Miguel-SLO/2228_AlarmeFenetre/2228_AlarmeFenetreOuverte/doc/Captures/2228_AlarmeSurFenetre.png

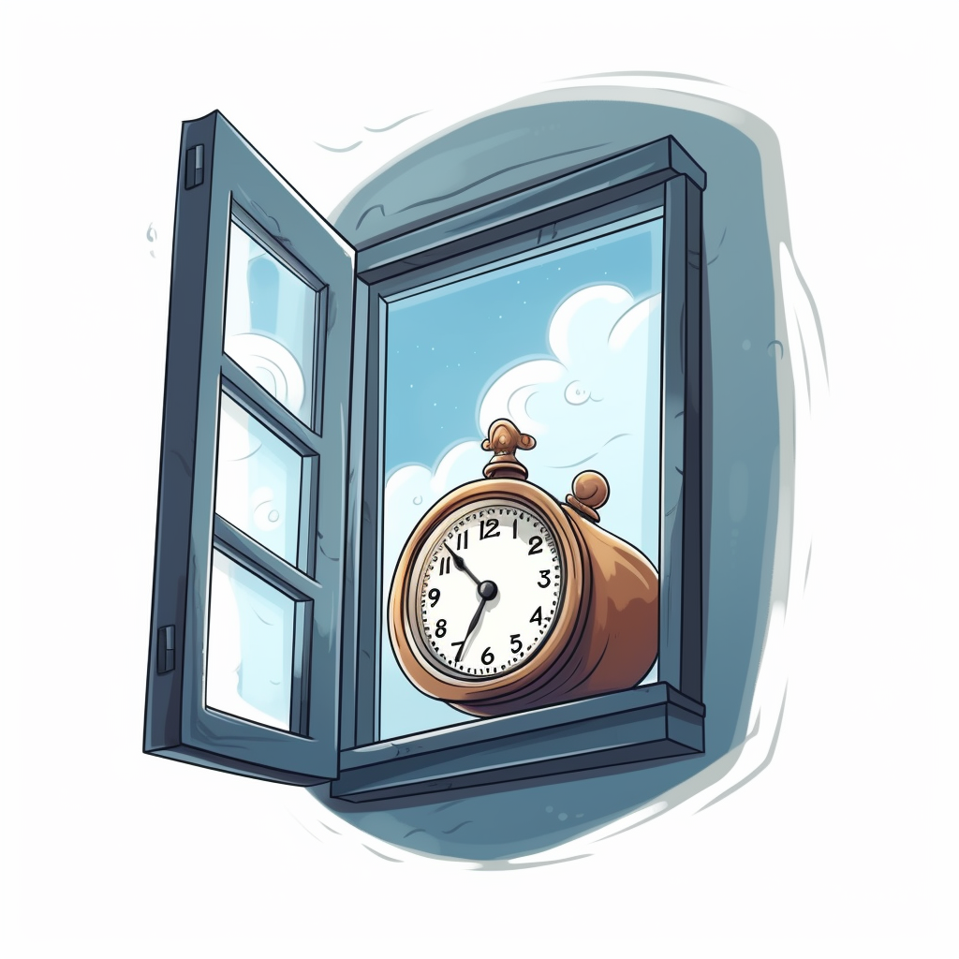
2228_AlarmeFenetreOuverte/doc/Captures/2228_AlarmeSurFenetre.png
