Miguel-SLO/2228_AlarmeFenetre/2228_AlarmeFenetreOuverte/doc/2228_AlarmeFenetreOuverte-Rapport-V1.docx

Génie électrique / électronique 3e semestre 2022-2023

Rapport de projet

2228

Alarme de fenêtre ouverte

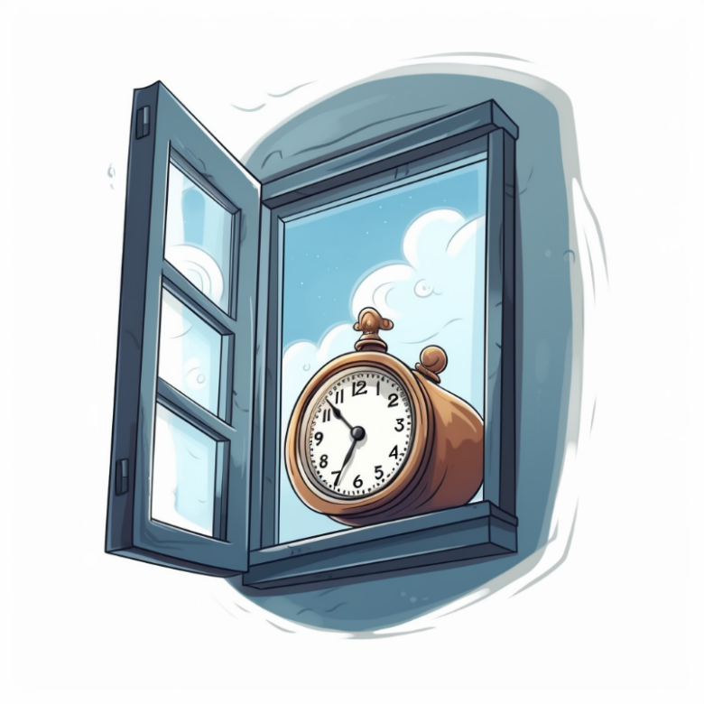
[picture p2: figure]

Réalisé par : À l’attention de :

Miguel Santos Serge Castoldi

Juan José Moreno

Début Fin

16 novembre 2022 14 juin 2023

# 1. Introduction

L’objectif de ce projet est la réalisation d’un dispositif permettant de détecter si une fenêtre est restée ouverte à certaines heures dans une salle de l’ETML-ES. Le cas échéant, une alerte sera envoyée par e-mail. Ce projet s’inspire des produits déjà présents sur le marché de la domotique.

Le cahier des charges est fournis à l’annexe 11.3.

Le planning complet du projet est fournis à l’annexe 11.5.

# 2. Pré-étude

## 2.1. Approche

Le projet sera constitué de deux parties distinctes :

- Multiples émetteurs, disposés à chaque fenêtre souhaitée.
- Un unique récepteur, placé dans la même salle que les fenêtres.

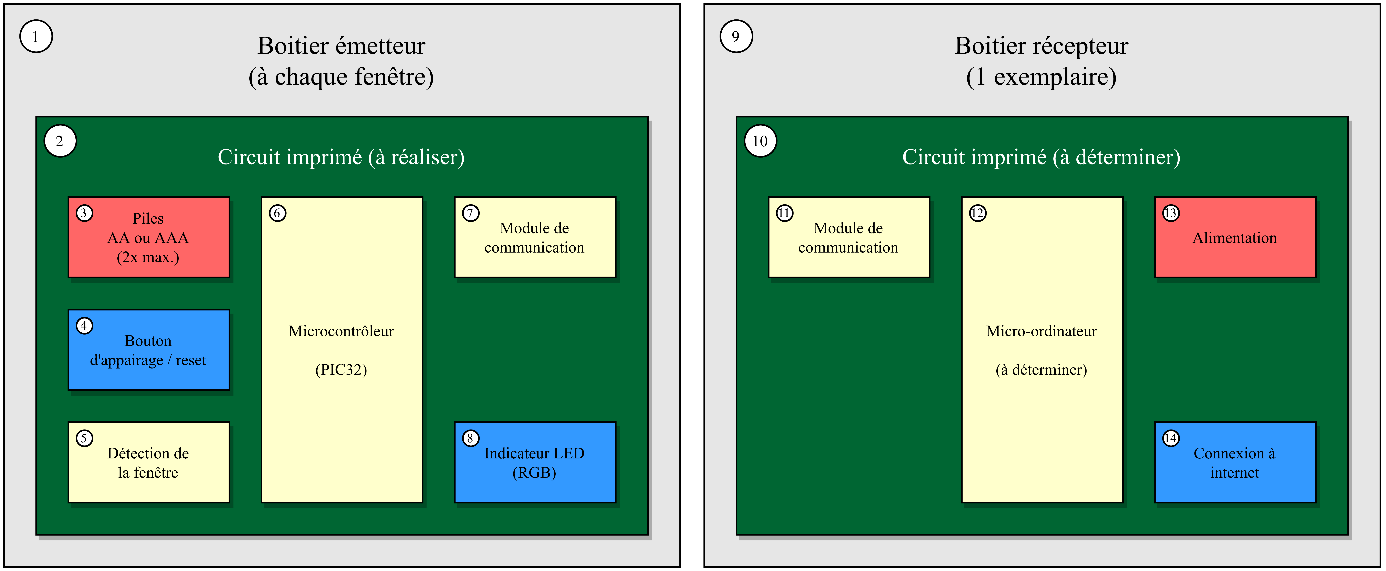
[picture p3: figure]

Figure 1 : Schéma-bloc de l'approche

## 2.2. Détection de la fenêtre

Pour réaliser la détection de la fenêtre, je me suis basé sur les produits équivalents disponible sur le marché. La méthode consiste à placer un aimant permanent sur la fenêtre et à le détecter à l’aide d’un capteur à effet Hall.

L’avantage réside dans la fiabilité de la mesure. La probabilité d’avoir un autre aimant perturbant notre circuit est extrêmement faible. En comparaison, un capteur optique pourrait se voir perturbé par de l’eau, une feuille ou tout autre objet se plaçant devant le capteur.

La consommation de ce genre de circuit est faible et sont proposé à de faibles prix. Ce qui en fait un choix idéal pour cette application.

## 2.3. Bouton

Un bouton sera accessible depuis l’extérieur du boitier pour permettre à l’utilisateur la réalisation de l’appairage ou de diverses configurations si nécessaires

## 2.4. LED RGB

Une LED sera placé afin d’indiquer à l’utilisateur l’état de chaque émetteur lors de l’appairage ou si une erreur survient par exemple. Elle devra être éteinte lors d’un fonctionnement normal pour réduire la consommation de courant.

## 2.5. Alimentation

Le cahier des charges proposait l’utilisation de deux piles AAA. Néanmoins, je me suis rapidement rendu compte des avantages que peuvent offrir des batteries au lithium. Pour cette raison, j’ai décidé de proposé deux approches différentes pour réaliser l’alimentation du circuit.

| Avantages | Inconvénients
Piles AAA alcaline | Facilité d’entretien Facilité de développement | Coût sur le long terme Grande quantité de déchets
Batterie lithium | Meilleure densité d’énergie Meilleure durabilité | Développement plus complexe Nécessite des circuits de charge et de protection Recharge annuelle nécessaire

Figure 2 : Comparaison entre piles et batterie

Le design devra déterminer lequel de ces deux méthodes sera le plus adapté à implémenter dans ce projet.

Dans les deux cas, un circuit de mesure de la charge du niveau d’énergie restant devra être réalisé. Il devra faire preuve d’un courant de fuite le plus faible possible.

## 2.6. Microcontrôleur et module de communication

### 2.6.1 Méthode PIC32

Pour cette partie, j’ai étudié deux méthodes différentes. La première était basé sur l’utilisation d’un PIC32 couplé à un module Xbee, intégrant un processeur ARM, permettant une communication par le protocole Zigbee.

Après avoir commencé ma pré-étude sur cette partie, j’ai jugé qu’il était peut-être exagéré d’intégrer deux processeurs pour une application qui est peu gourmande en ressources. De plus, le prix unitaire se retrouvait être très élevé.

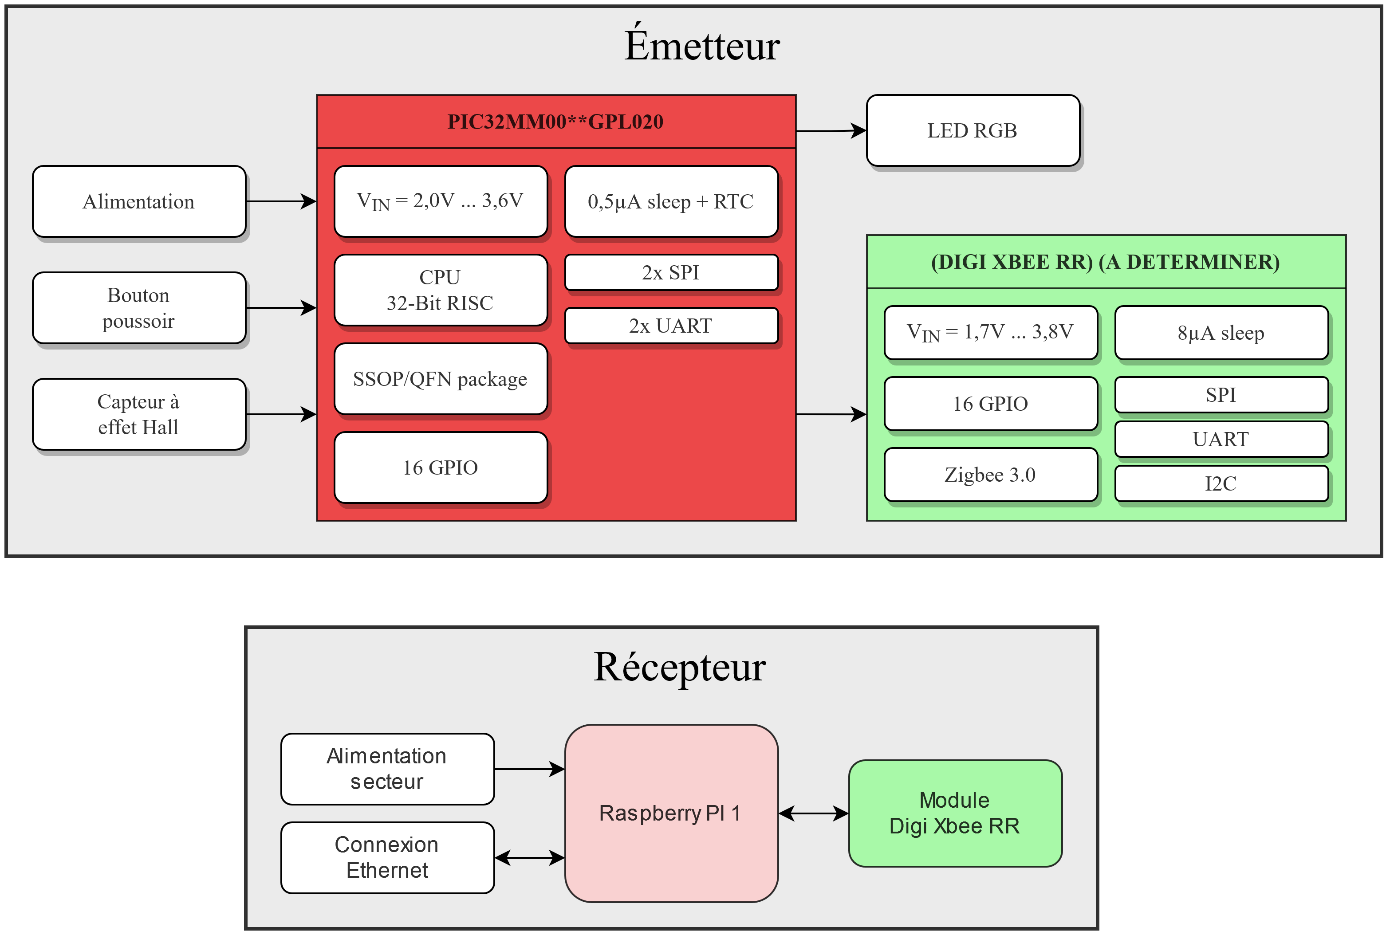
[picture p4: figure]

### 2.6.2 Méthode Nordic

J’ai donc étudié la possibilité d’utiliser un module « NRF52820 » du fabricant « Nordic Semiconductor ». J’ai eu l’occasion de le survoler rapidement lors de mon stage en entreprise. Il a l’avantage d’intégrer à la fois un CPU et un module de communication Zigbee, ainsi que plusieurs autres périphériques. De plus, il offre un prix bien plus avantageux que la méthode avec le PIC32.

Néanmoins, il était demandé d’intégrer un PIC32 dans le projet. Pour cela, j’ai donc décidé de le réaliser dans

Je souhaiterais privilégier cette méthode pour ces avantages techniques et économiques. Néanmoins, elle présente le désavantage d’être plus complexe à implémenter, mais cela me permettrait d’améliorer mes compétences personnelles en prévision de l’entreprise que j’intégrerai à la suite de mes études.

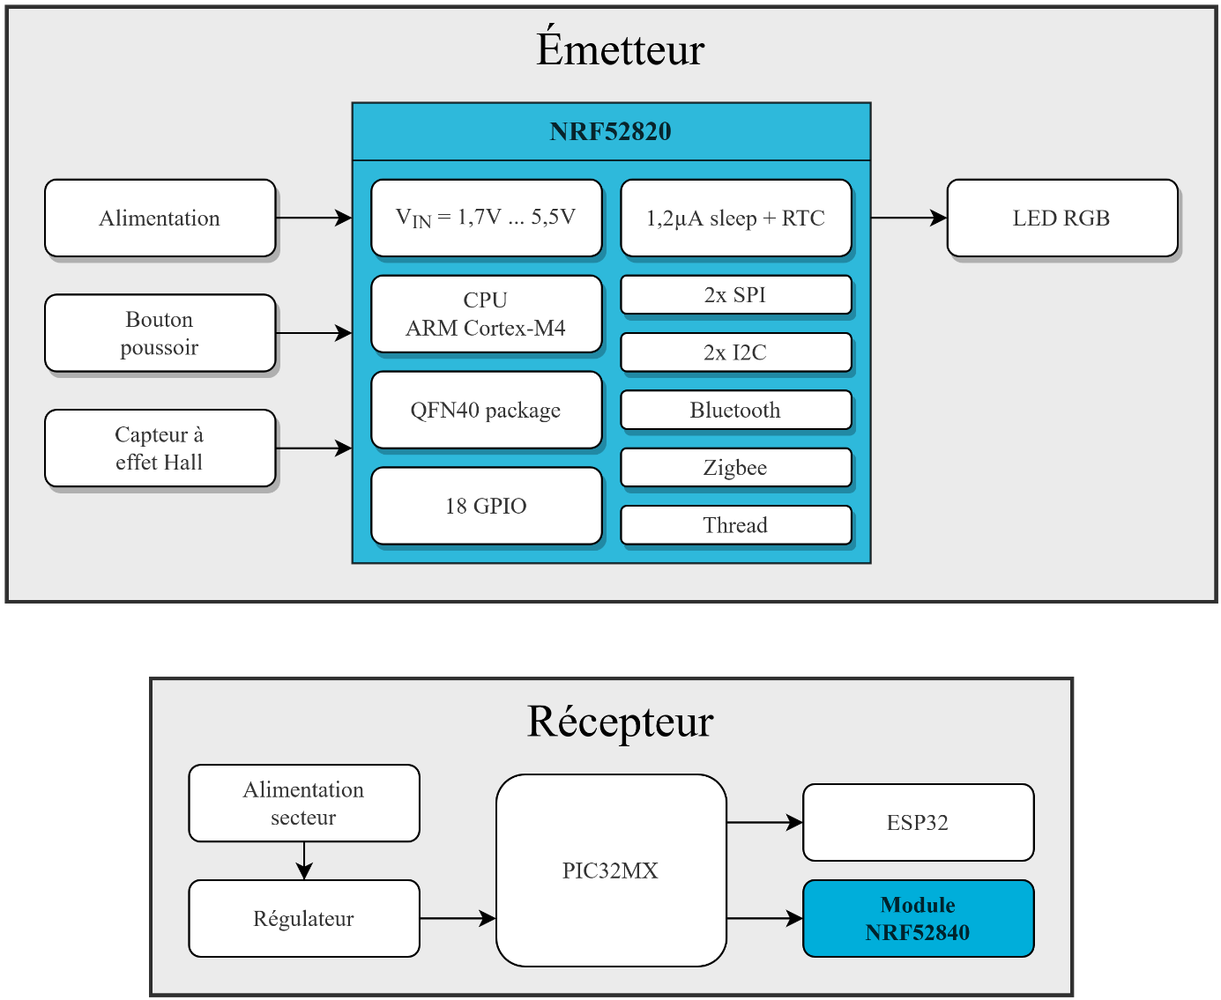
[picture p5: figure]

# 3. Boitiers

La réalisation des boitiers sera faite en impression 3D. De cette manière, une plus grande flexibilité est des designs plus pratique seront possible pour un coût équivalent en contrepartie de temps supplémentaires pour la conception.

# 4. Évaluation des coûts

Comme j’ai proposé deux méthodes pour ce projet, j’ai réalisé deux estimations des coûts distinctes. Certaines parties sont communes aux deux méthodes.

J’ai réalisé une estimation par unité, pour une salle complète (en moyenne 15 fenêtres) et une estimation si le projet devait être étendu à l’entièreté de l’école (environ 150 fenêtres) en considérant que chaque salle serait équipé d’un récepteur.

On peut voir que la méthode Nordic offre un avantage financier non négligeable. Ce qui appui ma volonté d’utiliser cette méthode.

# 5. Design

## 5.1. Choix des composants : Émetteur

### 5.1.1 Schéma bloc de l’émetteur

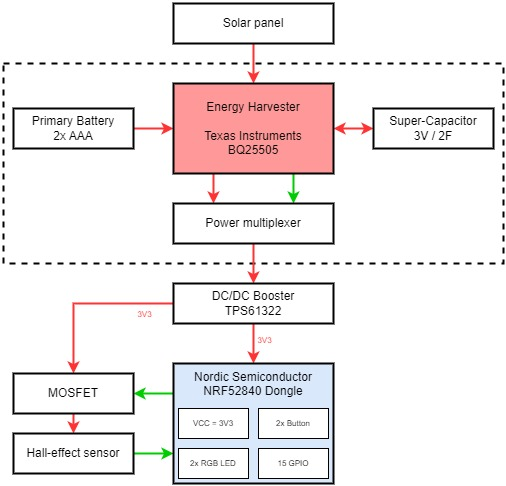
[picture p6: figure]

### 5.1.2 Cellule photovoltaïque | KXOB25-05X3F-TR

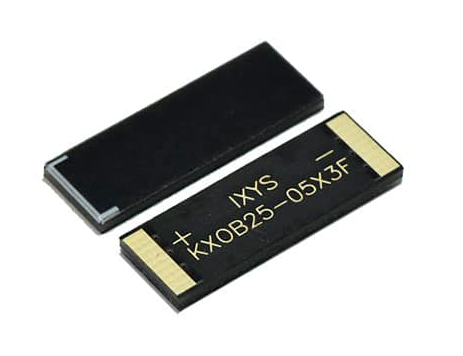
[picture p7: figure]

Le panneau solaire représente la source d’énergie principale de l’émetteur. Il devrait lui permettre d’atteindre une autonomie complète sans nécessiter de changement de piles ou batteries.

Composé de cellule photovoltaïque monocristalline, cela permettra d’exploiter toute la longueur d’onde de la lumière visible et en conséquence la lumière intérieure des néons.

Figure 3 : Cellule solaire ANYSOLAR

Le rendement élevé (25%) permettra de maximiser la quantité d’énergie captée dans une surface réduite. Les tensions sont parfaitement adaptées à la plage de fonctionnement du circuit de gestion décrit aux points suivants.

### 5.1.3 Energy harvester | BQ25505

Le BQ25505 de Texas Instrument est un circuit permettant la gestion de source d’énergie de très faible puissance. Il est en mesure de gérer le stockage dans un super-condensateur. En plus de cela, une batterie primaire peut-être relié au circuit pour offrir une source d’énergie supplémentaire et plus stable.

La datasheet fournit une application typique avec une cellule solaire.

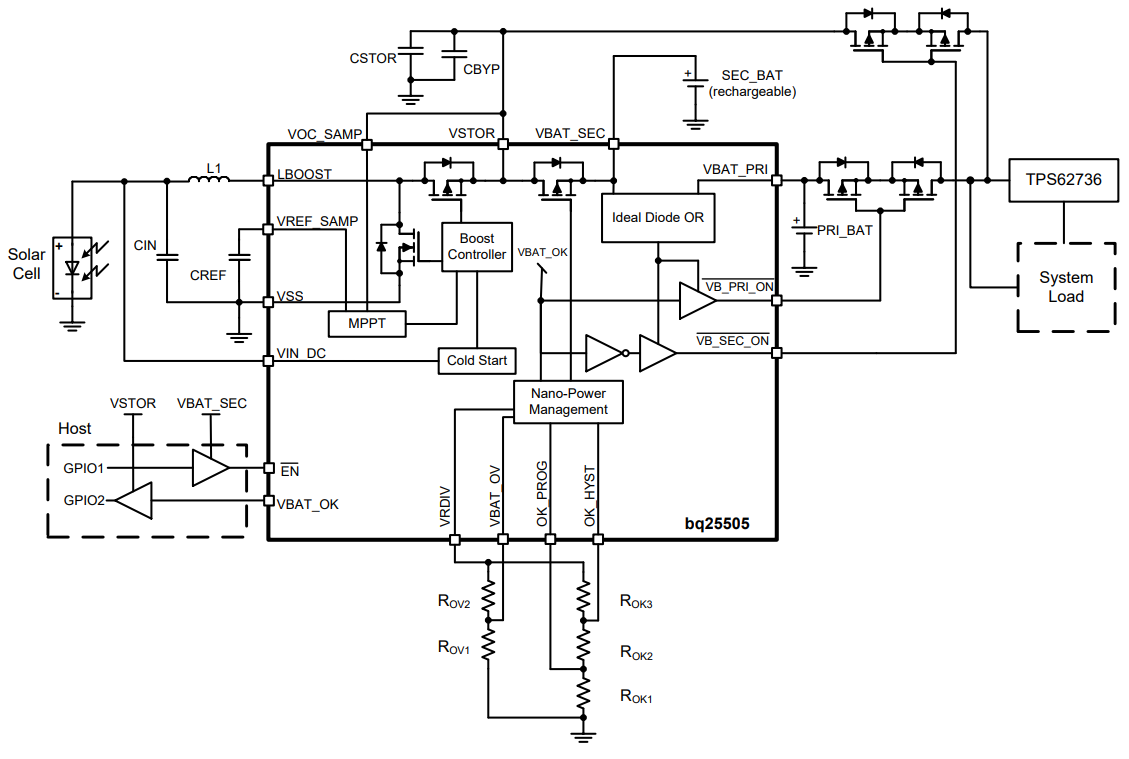
[picture p8: figure]

Figure 4 : Application typique BQ25505

#### Chargeur boost | C2 & L1

En entrée, un boost permet d’élever la tension de la cellule solaire. Les valeurs de composants à utiliser sont fournis par la datasheet (p. 20).

#### Protection de surtension | R1 & R2

Un pont résistif permet de fixer la tension maximale admissible sur la batterie secondaire (le super-condensateur). La formule est fournie par la datasheet (p. 13).

V_(BAT_(OV)) =3/2*V_(BIAS) *(1+(R_(OV2))/(R_(OV1)))

V_(BIAS) =V_(RDIV) =1.21 V

R_(OV2) +R_(OV1) =13 MΩ

Dû aux valeurs élevés de résistance et donc de courant très faible, une attention particulière doit être faite concernant le bruit pouvant perturber ce pont. De plus, les produits appliqués sur le circuit tel que le flux de la soudure ou les produits de nettoyages peuvent engendrer une résistance parallèle du même ordre de grandeur. Le fabricant fournit des recommandations dans la datasheet à ce sujet.

Figure 5 : Pont résistif fixant la valeur de protection de surtension

#### Stockage d’énergie | B1 & B2

Pour stocker l’énergie, un super-condensateur est utilisé. Celui-ci a été dimensionné grâce à un outil de calcul fourni par Texas Instrument. La plage de tension utile est celle entre la tension minimale de sortie du BQ25505 et la tension maximale du condensateur. Pour maximiser cette plage, il faut donc choisir un condensateur avec la plus haute tension possible. Néanmoins, pour éviter d’avoir des coûts trop élevés, j’ai préféré en choisir un d’une tension de 3V avec une plus grande capacité.

Figure 6 : Stockage d'énergie

#### Condensateurs | C3 & C4 & C5

Le condensateur C3 est nécessaire pour que le circuit puisse fixer sa tension de référence en interne. Il est particulièrement sensible aux courant de fuites et doit les éviter au maximum tout en étant d’une précision la plus grande possible. Il doit être au minimum de type X7R ou COG.

Les condensateurs C4 et C5 sont les condensateurs de sortie et leur valeur est fixée par la datasheet.

De manière globale, tous les condensateurs reliés au BQ25505 doivent posséder le courant de fuite le plus faible possible afin augmenter le rendement global.

Figure 7 : Condensateurs de sortie | Figure 8 : Condensateur de référence

#### Multiplexeur | U5 & U6

Le BQ25505 offre la possibilité de multiplexer les différentes sources de stockage pour notamment automatiquement commuter sur la batterie primaire lorsque la secondaire n’a plus assez d’énergie ou une tension trop faible.

### 5.1.4 Régulateur 3V3 | U4

La tension fournit par le super-condensateur sera variable par nature. Pour la stabiliser, il faut veiller à utiliser un régulateur 3V3. Les composants ont été dimensionné grâce à l’utilitaire « WEBENCH » de Texas instrument.

### 5.1.5 Capteur à effet hall

Pour détecter la présence ou non de la fenêtre, j’ai décidé d’implémenter un capteur à effet hall agissant comme un interrupteur. La présence d’un champ magnétique supérieure à une valeur définie fera passer la sortie à un niveau logique haut.

Pour réduire le risque de courant de fuite dans le capteur, un MOSFET est installé sur son alimentation qui sera contrôlé par le processeur.

### 5.1.6 NRF52840 USB Dongle

Le processeur utilisé sera le NRF52840 de Nordic Semiconductor. Pour simplifier le développement, j’ai choisi un module tout-en-un.

Le module permettra la communication en Zigbee avec le récepteur. Pour le programmer, une connexion par USB à un ordinateur sera suffisante. Nordic fournit plusieurs logiciels et exemple de code pour cela.

## 5.2. Choix des composants : Récepteur

### 5.2.1 Schéma bloc du récepteur

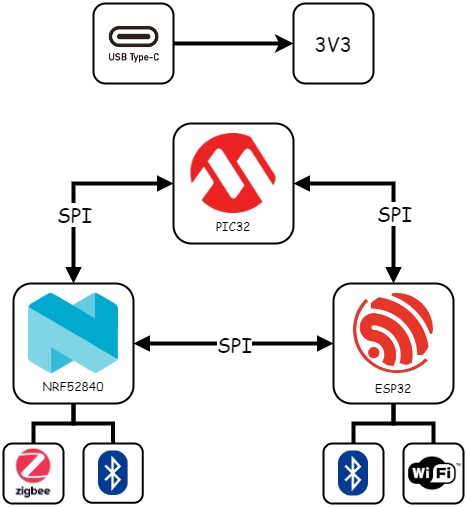
[picture p9: figure]
schemaBloc_Recepteur

### 5.2.2 Connecteur USB

Le récepteur sera alimenté à l’aide de la tension de 5V fournit par un port USB-C.

### 5.2.3 Régulateur 3V3

Pour assurer l’alimentation des différents circuits, une conversion en 3V3 est nécessaire. Mon choix a été mis en commun avec le restant de la classe et en fonction du stock disponible à l’ES.

### 5.2.4 Processeurs et empreintes MIKROE

Le même module NRF52840 utilisé pour l’émetteur sera présent pour assurer la communication en Zigbee.

Des empreintes MIKROE ont été utilisé afin de permettre une certaine flexibilité dans le choix d’un module pour réaliser la connexion WIFI

Un PIC32 assurera le contrôle central entre les différents modules à l’aide de connexions SPI et UART.

# 6. Hardware

## 6.1. PCB de l’émetteur

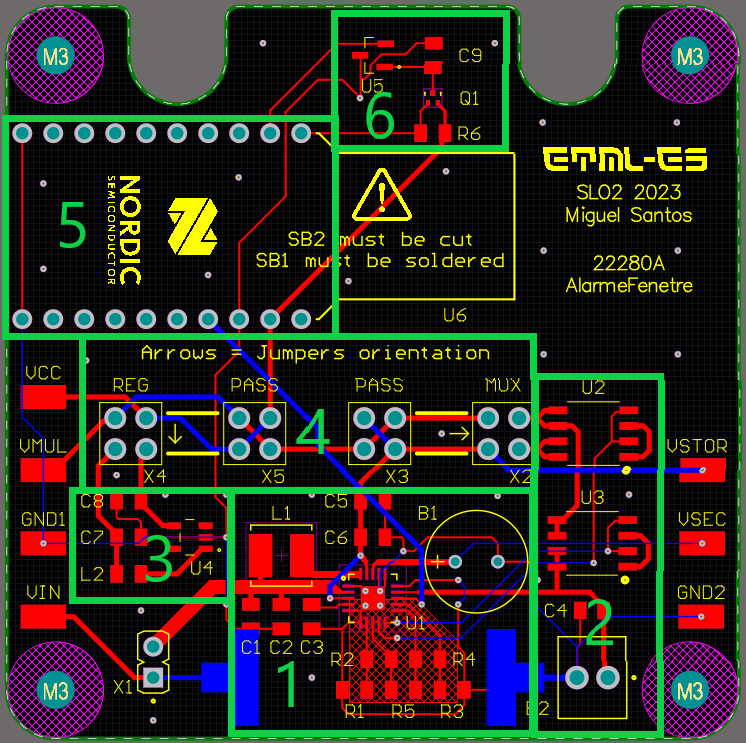
[picture p10: figure]

Figure 9 : PCB de l'émetteur

Les plans de masse ont été retirés de l'image pour améliorer la visibilité des pistes et des composants.

Les encoches sur le bord du PCB sont destinées à permettre le passage des colonnettes du boîtier, ce qui permet de gagner de la place. Les trous dans les coins servent à fixer le PCB solidement à l'intérieur du boîtier.

Les pointes de test ont été placées sur les bords du circuit pour faciliter l'accès avec des sondes de mesure lors des tests.

Les éléments identifiés sur l'image (Figure 9) sont décrits ci-dessous :

1) Panneau solaire | « Energy harvester » | Super-capacité

La piste VIN a été conçue aussi large que possible pour minimiser l'impédance. Étant donné les très faibles courants en jeu, la largeur de la piste a peu d'importance

Le panneau solaire est placé sur la couche inférieure pour qu’il puisse être le plus près possible de l’extérieur du boitier. La forme en "T" du footprint a été spécifiquement choisie pour faciliter le processus de brassage des pads qui ont leurs connexions uniquement en dessous du composant.

Une zone de "keep-out" est placée autour des ponts résistifs, qui ont des valeurs élevées, pour éviter les impédances parasites.

Les condensateurs C1 à C3 sont placés au plus proche de l’entrée du BQ25505.

Les composants sont légèrement espacés de la bobine L1 pour éviter les perturbations causées par le boost en entrée.

2) Multiplexage des sources d’alimentations

Placé pour garantir le chemin le plus court entre la pile et les jumpers

3) Régulateur 3V3
4) Bypass des blocs

L’orientation de placement des jumpers est indiquée par des flèches.

Les jumpers « PASS » peuvent être placés dans n’importe quel sens

Les circuits sont protégés physiquement si jumpers placés dans le mauvais sens.

5) NRF52840 USB Dongle

Le fabricant recommande de ne rien placer sous la partie de l’antenne présente sur le module, c’est pour cette raison qu’il dépasser légèrement du bord du PCB.

6) Capteur magnétique

Placé au bord du circuit pour détecter l’aimant externe.

Les différents fichiers nécessaires à la production sont fournis en annexe.

## 6.2. PCB du récepteur

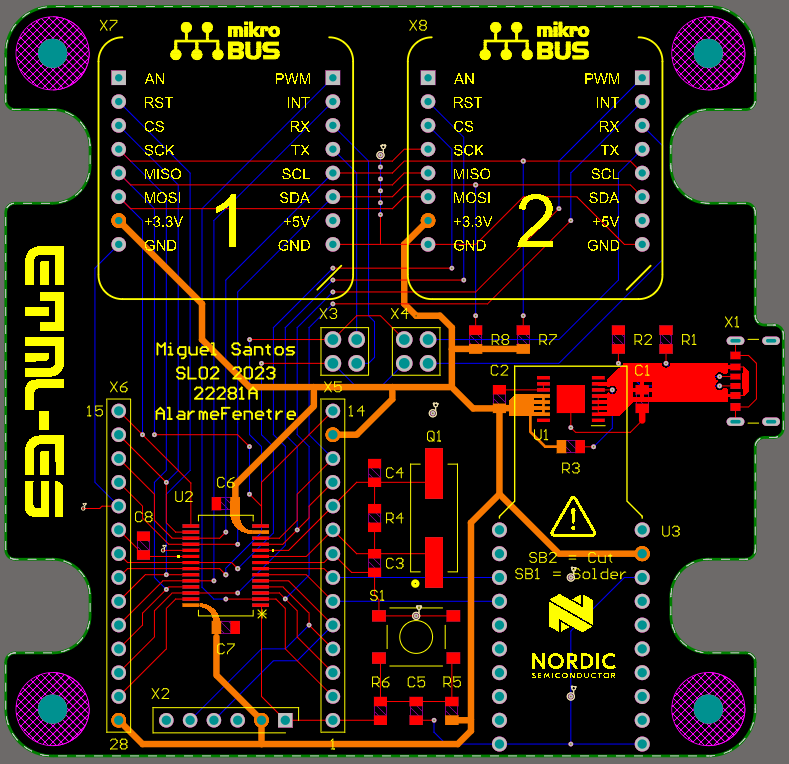
[picture p11: figure]

Figure 10 : PCB du récepteur

Les plans de masse ont été retirés de l'image pour améliorer la visibilité des pistes et des composants. Les pistes de couleur orange indiquent la connexion 3V3.

En entrée d’alimentation du port USB, des pistes larges ont été utilisées pour réduire l'impédance.

Des headers ont été utilisés comme pointes de test pour chaque patte du microcontrôleur.

Le NRF52840 a été positionné près du bord, de manière similaire à l'émetteur. Les empreintes mikroBUS ont été placées près du bord pour les mêmes raisons, en prévision d'une éventuelle antenne et pour laisser suffisamment d'espace, étant donné que certains modules Mikroe sont de taille assez importante.

Des encoches et des trous ont été ajoutés, de manière similaire à l'émetteur, pour permettre une fixation éventuelle dans un boîtier (le boîtier est facultatif).

Les différents fichiers nécessaires à la production sont fournis en annexe.

## 6.3. Boitier de l’émetteur

Un boitier composé d’un boiter principal et d’un couvercle a été développé pour l’émetteur en utilisant SolidWorks. Il a ensuite été imprimé en 3D en PLA. Une ouverture a été réalisée pour permettre à la cellule solaire l’accès à la lumière. Un « socle » permet aussi d’y fixer un support de pile.

Les fichiers de cotations sont disponibles en annexes.

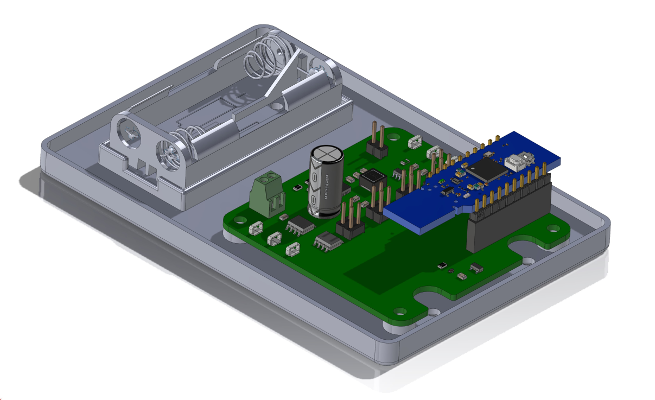
[picture p12: figure]

Figure 11 : Intérieur du boitier 3D

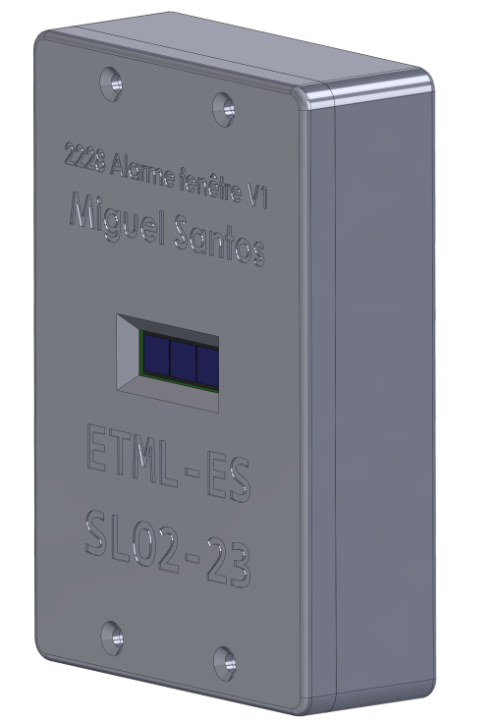
[picture p13: figure]

Figure 12 : Boitier vu de l'extérieur

# 7. Montage et mise en service

Après avoir finalisé la conception de mon circuit, j'ai procédé à la commande des différents composants et PCB. J'ai commandé deux unités pour l'émetteur et une unité pour le récepteur.

Le montage des composants a été réalisé par brasage à la main, à l'exception du BQ25505 de l'émetteur que j'ai tenté de souder au four. Malheureusement, cette méthode n'a pas donné de résultats satisfaisants en termes de soudures. J'ai essayé de reprendre les soudures à la main, mais je n'ai pas réussi à obtenir une connexion solide sur ma première carte. J'ai donc réalisé la deuxième carte entièrement à la main, ce qui a abouti à de bons résultats, comme décrit plus loin dans ce rapport.

Pour l'émetteur, il n'était pas possible de monter les composants de manière progressive, mais j'ai utilisé des jumpers pour isoler certaines parties du PCB. Après avoir terminé le montage, j'ai vérifié progressivement l'absence de court-circuit et la présence des tensions appropriées. Tout était conforme, et aucune erreur de conception n'a été détectée. Pour la carte mal soudée, la charge de la super-capacité ne fonctionnait pas, mais comme le multiplexage des sources d’alimentations fonctionne, le circuit est utilisable avec des piles.

En ce qui concerne le récepteur, j'ai d'abord monté le régulateur 3V3 pour vérifier la tension de sortie, ce qui s'est avéré conforme. Ensuite, j'ai procédé au montage du reste du PCB. Lorsque j'ai tenté d'établir une communication avec le microcontrôleur, j'ai remarqué que les broches PGEC et PGED de programmation étaient inversées. Pour résoudre ce problème, j'ai fabriqué un câble croisé pour inverser ces deux broches. Ce câble est inclus dans la boîte du projet avec les circuits.

Les modifications à apporter sont récapitulées en annexe du rapport.

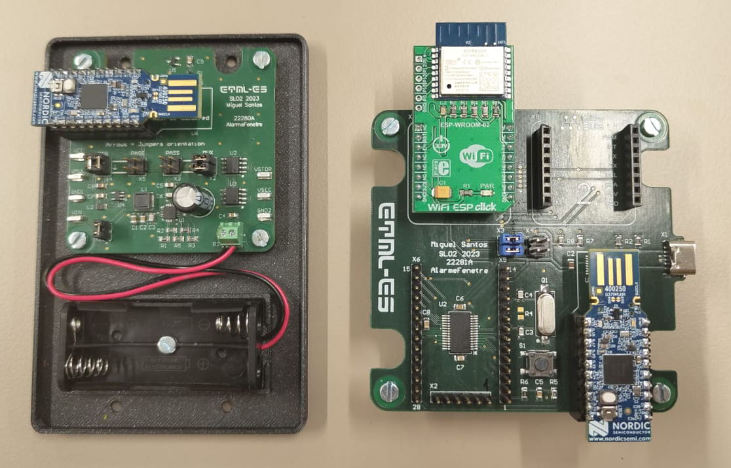
[picture p14: figure]

Figure 13 : Photos des circuits montés

# 8. Software

Dans le cadre de la programmation du NRF52840, une machine virtuelle est mise à disposition dans le dossier "soft" du projet. Cette machine virtuelle est préconfigurée avec tous les logiciels nécessaires, notamment :

- Visual Studio Code : Il s'agit d'un environnement de développement utilisé pour programmer des applications en langage C. Un plugin spécifique à Nordic Semiconductor est installé, ce qui permet d'accéder facilement à de nombreux exemples et de configurer aisément tous les aspects du NRF.
- NRF Connect : C'est un logiciel propriétaire développé par Nordic Semiconductor. Il est utilisé pour installer le NRF SDK et pour programmer le module NRF52840.

## 8.1. Logique de programmation du NRF52840

Le NRF52840 USB Dongle utilise une approche de programmation différente de celle du PIC32. Il est pris en charge par le projet "Zephyr", qui est un système d'exploitation temps réel (RTOS) conçu spécifiquement pour les systèmes embarqués dotés de microcontrôleurs ou de ressources limitées. Zephyr permet une gestion efficace du matériel grâce à diverses bibliothèques.

Contrairement au PIC32, le système basé sur le NRF52840 s'appuie sur trois types de fichiers principaux :

- Les fichiers "Kconfig" ou ".conf" génèrent les définitions des différentes configurations de notre système. Ces fichiers permettent de spécifier les bibliothèques, les protocoles de communication utilisés et d'autres paramètres de configuration.
- Le "Devicetree" et ses fichiers ".dts" décrivent le matériel présent sur la carte. Ces fichiers fournissent une représentation structurée des périphériques, des broches et des ressources matérielles utilisées par le système.
- Les fichiers sources ".c" et les en-têtes ".h" sont utilisés pour créer l'application spécifique. Ces fichiers contiennent le code source de l'application et les déclarations des fonctions et des structures nécessaires. Le compilateur se charge ensuite de lier ces fichiers pour générer le binaire final.

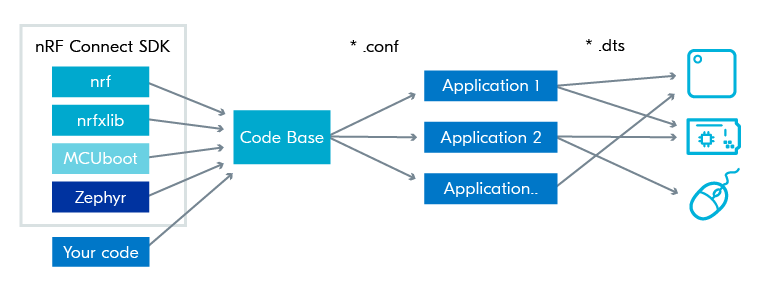
[picture p15: figure]

Figure 14 : NRF52840 types de fichiers

Cette méthode permet ainsi de créer une indépendance totale entre le software et le hardware. Les librairies créées peuvent être facilement utilisées sur une autre carte.

## 8.2. Software émetteur : NRF52840

Le code de l'émetteur est conçu de manière assez simple. Son fonctionnement repose sur la récupération de la valeur du capteur à effet Hall après avoir reçu une interruption via le protocole Zigbee, puis il renvoie cette valeur en utilisant le même protocole.

Cependant, durant le développement, les protocoles de communication se sont avérés plus complexes que prévu. J'ai alors envisagé d'utiliser le Bluetooth, mais j'ai rencontré des difficultés similaires. Les défis auxquels j'ai été confronté comprenaient des problèmes de compilation du code et de compréhension. J’ai tenté d’effectuer des recherches approfondies et étudier attentivement la documentation des protocoles de communication, malheureusement sans succès.

Un listing du fichier main.c est fournis en annexe. J’ai réalisé certains tests avec les LEDS et interruptions, qui sont détaillés dans la section de test de fonctionnement. Voici le schéma bloc du fonctionnement théorique :

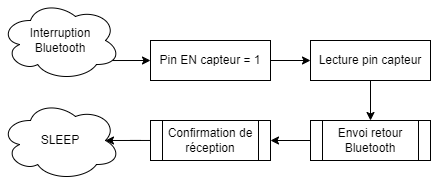
[picture p16: figure]

Figure 15 : Schéma-bloc du NRF de l'émetteur

## 8.3. Software récepteur : NRF52840

Le module NRF utilisé sur le récepteur a présenté des problèmes similaires à ceux rencontrés avec l'émetteur. Un listing du fichier main.c est fourni en annexe.

J'ai effectué quelques tests en utilisant les LED, les interruptions et l'UART, qui sont détaillés dans la section de test de fonctionnement. Pour mieux comprendre le fonctionnement théorique, voici le schéma bloc :

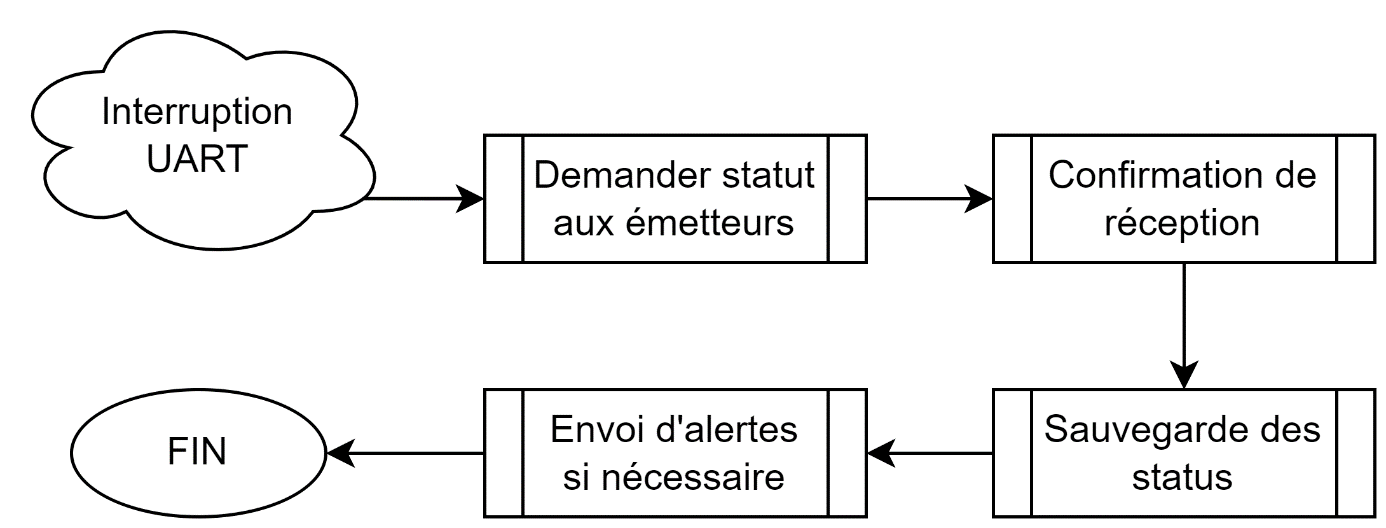
[picture p17: figure]

Figure 16 : Schéma bloc du NRF du récepteur

## 8.4. Software récepteur : PIC32MX130

Le but du PIC32 est d’assurer la communication entre le module NRF et l’éventuelle module de communication Wifi ou SMS. Grâce à la RTCC intégré au PIC32, une alerte peut être programmé à une heure précise pour récupérer l’état des émetteurs et lever une alerte.

Actuellement, seule une application de test de communication en UART a été réalisé. L’UART a été configuré pour correspondre aux paramètres de celui du NRF.

Voici la méthode qui devrait être théoriquement développé :

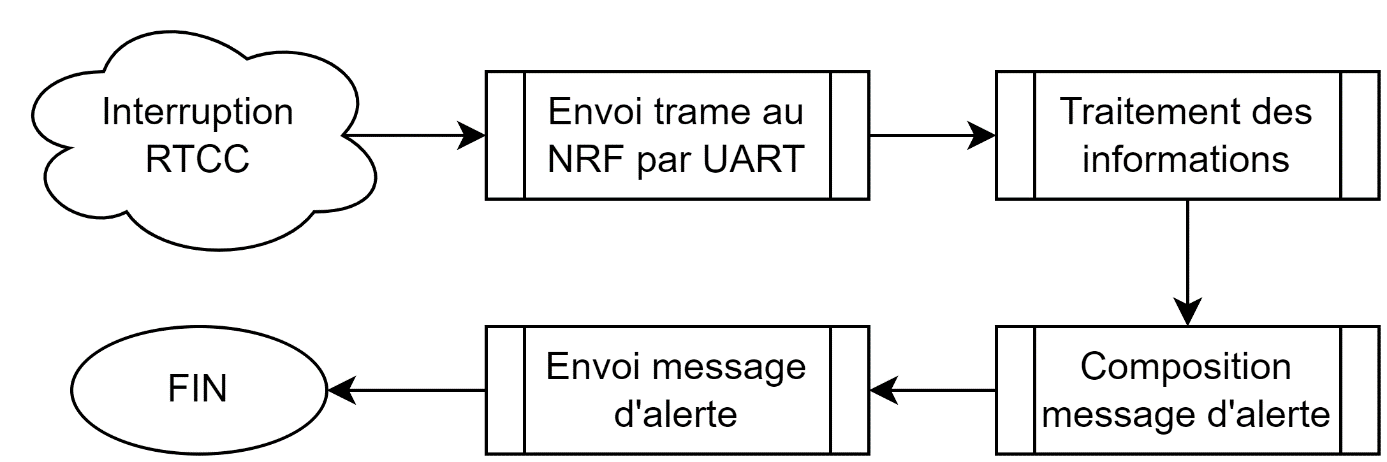
[picture p18: figure]

Figure 17 : Schéma bloc du PIC32 du récepteur

Voici comment a été configuré l’UART sur le PIC32 :

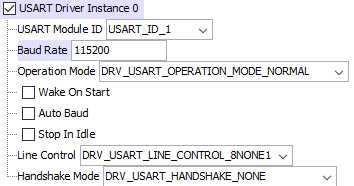
[picture p19: figure]

Figure 18 : Configuration UART sur le PIC32

Grâce à Harmony sur MPLAB, j’ai réalisé la configuration des pins du PIC32 en me basant sur le schéma électrique du récepteur.

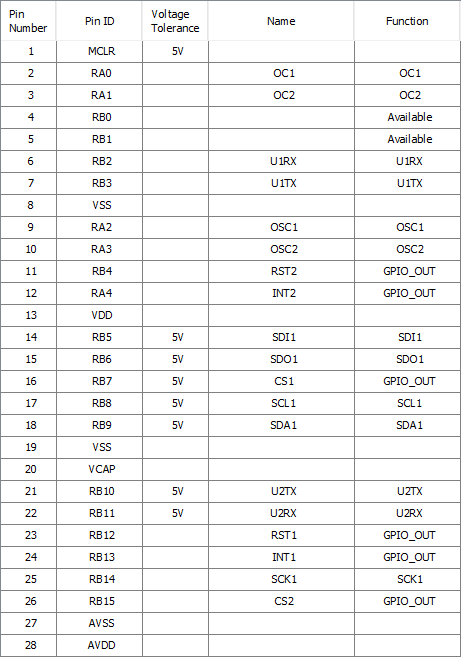
[picture p20: figure]

Figure 19 : Configuration des pins du PIC32

## 8.5. Tests de fonctionnement

### 8.5.1 Seuils de tension de la super-capacité

J'ai effectué des mesures pour évaluer le fonctionnement des seuils de sous-tension et de surtension de la super-capacité. Pour ce faire, j'ai développé un programme qui active toutes les LED sur le module NRF afin de consommer le maximum d'énergie. J'ai rechargé manuellement la super-capacité à l'aide d'une alimentation externe pour accélérer le processus. J'ai ensuite mesuré le signal "VBAT_OK" qui indique si la tension de la batterie se situe dans la plage acceptable, en prenant en compte l'effet d'hystérésis.

Channel | Signal
C1 | VSEC
C2 | VBAT_OK

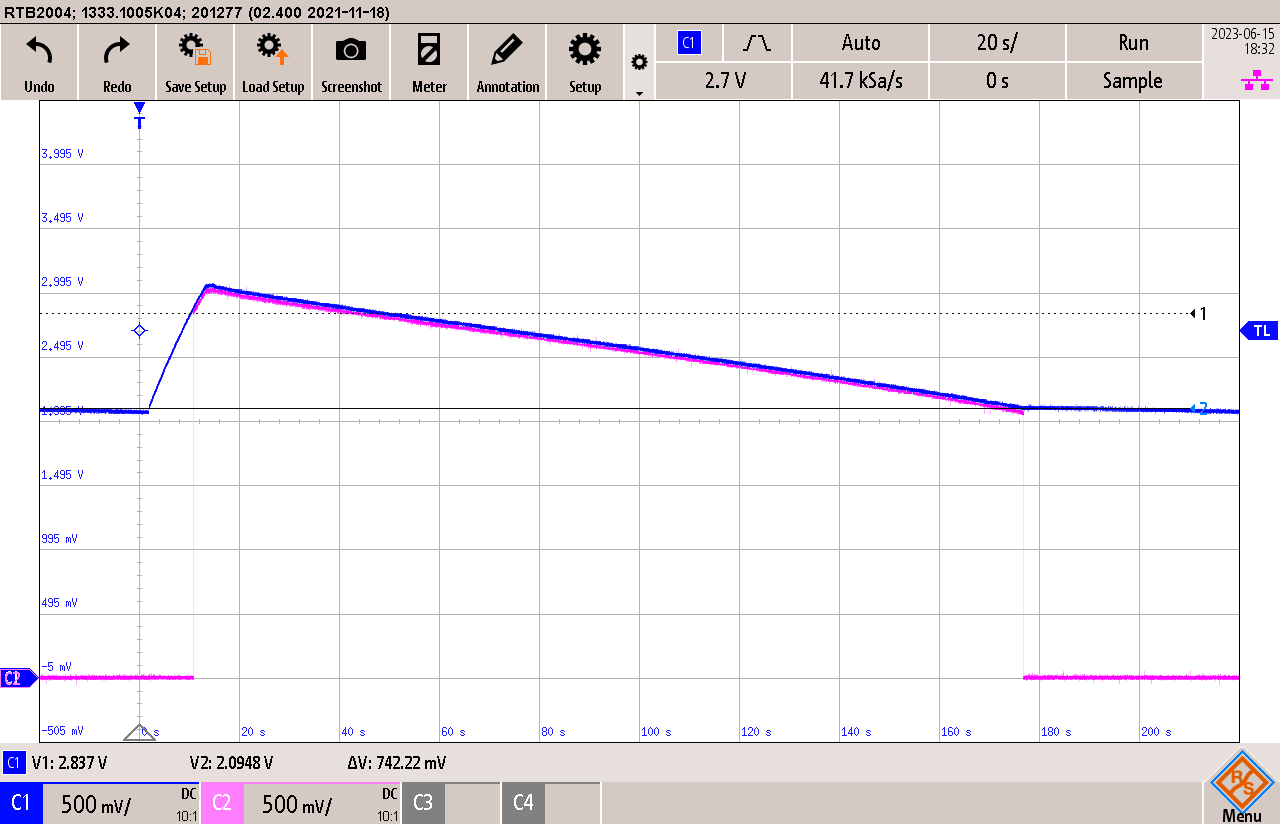
[picture p21: figure]

Figure 20 : Mesure de tests des seuils de tensions

Pendant la phase de conception, j'ai dimensionné les résistances pour obtenir des valeurs spécifiques. Les valeurs obtenues sont bien celles qui étaient attendues :

Nom | Valeur théorique | Valeur mesurée | Différence rel.
VBAT_OK | 2,1 V | 2,09 V | -0,47 %
VBAT_OK_HYST | 2,9 V | 2,83 V | -2,47 %

La plage de tension de fonctionnement a été légèrement réduite, ce qui entraîne une diminution de l'autonomie de la super-capacité. Cependant, dans ce cas précis, cette réduction est négligeable et n'affecte pas de manière significative les performances globales du système.

### 8.5.2 Fonctionnement du capteur à effet hall

Afin de tester le fonctionnement du capteur à effet Hall, j'ai développé un programme qui allume une LED lorsqu'un signal est détecté par le capteur. Cela permet de vérifier que le microcontrôleur réagit correctement aux signaux du capteur. Pour effectuer ce test, le capteur était maintenu en marche en continu.

Channel | Signal
C1 | MAG_OUT
C2 | LED0

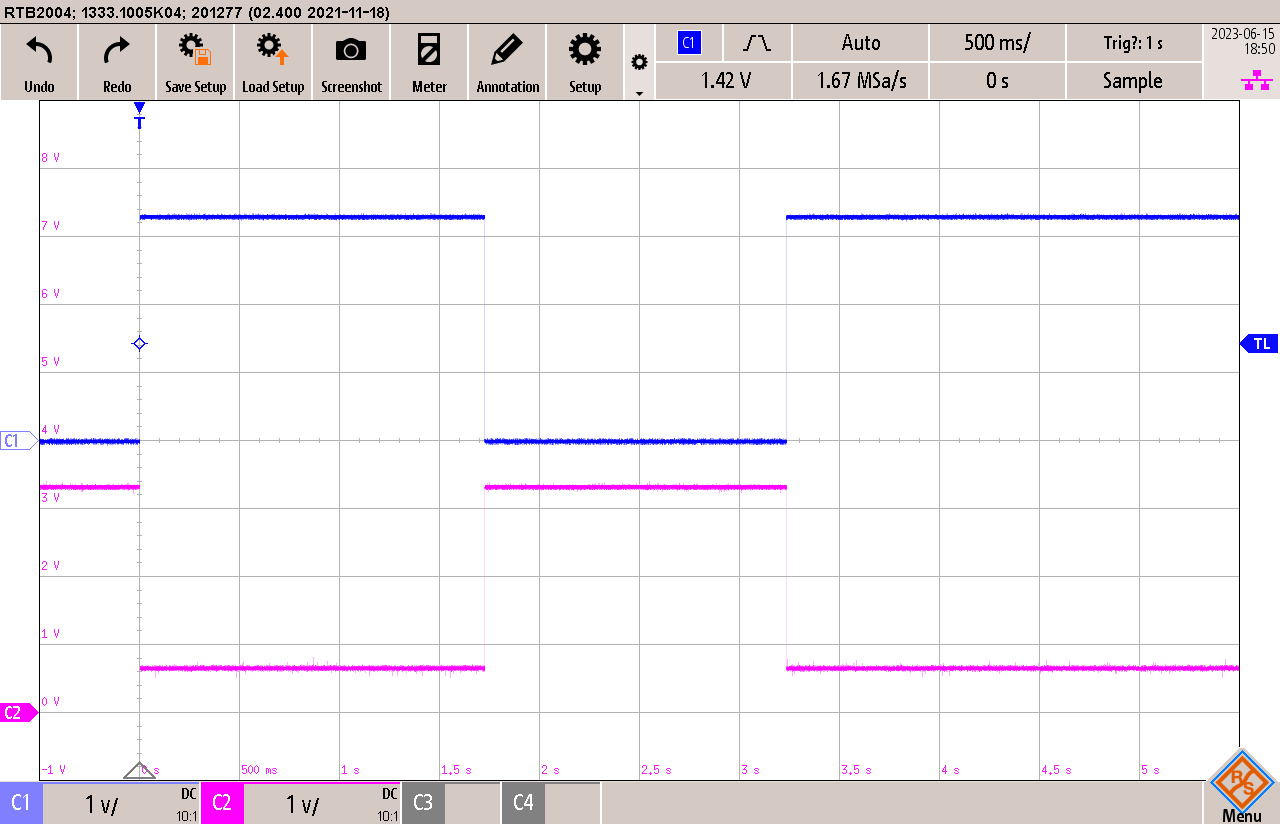
[picture p22: figure]

Figure 21 : Mesure de test du capteur à effet Hall

En approchant un aimant du capteur à effet Hall, le capteur réagit en tirant le signal à la masse, ce qui entraîne l'allumage de la LED comme prévu. Cette observation confirme le bon fonctionnement du capteur. Cependant, il convient de noter que l'aimant initialement commandé, tel que spécifié dans la liste des composants (BOM), s'est avéré être insuffisamment puissant. Pour contourner ce problème, j'ai pu utiliser un aimant disponible dans notre classe qui satisfait les besoins du test.

### 8.5.3 Communication UART

Pour évaluer le fonctionnement de la communication UART entre le PIC32 et le module NRF, j'ai développé un programme sur le module NRF qui réagit à la réception d'une trame spécifique (0x0F) en alternant l'état d'une LED. Cette approche me permet de tester à la fois l'interruption UART et le contrôle des données.

Channel | Signal
C1 | (PIC32) TX1
C2 | (NRF) LED2

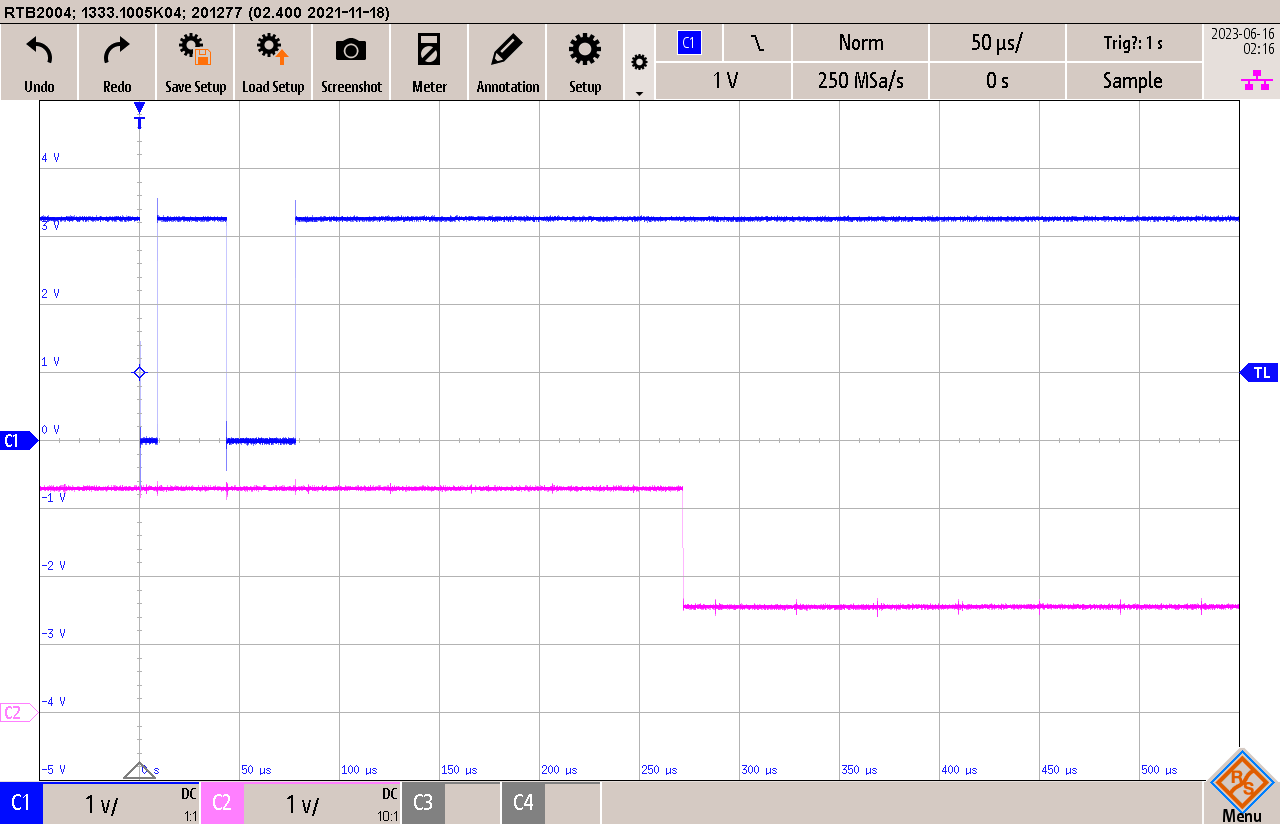
[picture p23: figure]

Figure 22 : Mesure de test de l'UART

L'observation de cette approche permet de conclure que la communication entre le PIC32 et le module NRF via l'UART fonctionne correctement. Cela indique également que l'UART a été configuré de manière adéquate sur le module NRF. Les tests effectués ont démontré une réception précise de la trame spécifique (0x0F) par le module NRF, déclenchant ainsi l'interruption UART et contrôlant avec succès l'état de la LED correspondante.

# 9. État final

Le projet actuel présente un état encourageant au niveau du hardware, car celui-ci est opérationnel dans l'ensemble. Cependant, il y a quelques points qui nécessitent une attention particulière pour améliorer son fonctionnement.

Tout d'abord, la première carte de l'émetteur requiert un changement du circuit BQ25505 afin de rendre opérationnelle la charge de la super capacité.

De plus, une légère modification au niveau du port de programmation du récepteur est nécessaire pour éviter de recourir à un câble croisé.

Cependant, un défi majeur se présente au niveau du logiciel. En effet, il y a une certaine lacune dans l'implémentation des protocoles de communication. Plus précisément, il manque le protocole WiFi sur le module ESP Mikroe, qui limite les possibilités de connectivité sans fil du projet.

De plus, il est également nécessaire d'ajouter le protocole Bluetooth ou idéalement Zigbee sur le module NRF pour offrir des options de communication entre les différents émetteur et récepteurs.

En résumé, bien que le matériel du projet soit en grande partie fonctionnel, des améliorations sont nécessaires pour parvenir à une pleine opérationnalité. Les priorités actuelles incluent les modifications hardware et l'ajout des protocoles WiFi, Bluetooth ou Zigbee pour renforcer les capacités de communication du système.

# 10. Conclusion

En conclusion, ce projet s'est révélé être un défi complexe et stimulant, malgré son apparence initialement simple. Il s'est articulé autour de deux aspects clés qui étaient la gestion de l'énergie et la communication sans fil via des protocoles spécifiques.

Du côté matériel, j'ai obtenu des résultats encourageants en ce qui concerne le fonctionnement du panneau solaire, la réussite de la charge de la super-capacité, ainsi que la mise en place du mécanisme de transition automatique entre la super-capacité et les piles.

Cependant, j'ai fait preuve d'une ambition excessive en choisissant le module NRF52840, ce qui a été une tâche plus ardue que prévu. J'ai sous-estimé les défis associés à l'apprentissage d'un nouveau microcontrôleur, surtout lorsque celui-ci présente une logique fondamentalement différente de celle à laquelle j'étais habitué. Cela a nécessité un investissement en temps considérable pour me familiariser avec ses fonctionnalités et comprendre son fonctionnement. Malheureusement, cela a entraîné des retards considérables dans l'avancement de mon projet, au point de ne pas pouvoir atteindre les parties relatives aux protocoles de communication. Mon choix ambitieux du module NRF52840 a nécessité un investissement de temps important pour en comprendre les fonctionnalités et le fonctionnement, ce qui a finalement eu un impact négatif sur la réalisation de ces aspects essentiels du projet.

Cette expérience m'a apporté une précieuse leçon sur l'importance de l'évaluation minutieuse des exigences et des compétences nécessaires avant d'entreprendre de nouveaux projets. À l'avenir, je serai plus réaliste dans mes ambitions et j'accorderai une attention particulière à l'analyse approfondie des spécifications techniques et des challenges associés.

Dans l'ensemble, ce projet m'a permis de développer mes compétences techniques, ma résilience face aux obstacles et ma capacité d'adaptation à de nouvelles technologies. Je suis convaincu que les enseignements tirés de cette expérience me seront précieux pour mes projets futurs, en m'aidant à prendre des décisions plus éclairées et à atteindre des résultats encore plus remarquables.

Lausanne, le 16 juin 2023

Miguel Santos

# 11. Annexes

## 11.1. Résumé du projet

## 11.2. Affiche de projet

## 11.3. Cahier des charges

## 11.4. Fiche de modification

## 11.5. Planning

## 11.6. Journal de travail

## 11.7. Émetteur : Schéma électrique

## 11.8. Émetteur : BOM

## 11.9. Émetteur : Schéma d’implémentation

## 11.10. Émetteur : Schéma mécanique

## 11.11. Récepteur : Schéma électrique

## 11.12. Récepteur : BOM

## 11.13. Récepteur : Schéma d’implémentation

## 11.14. Récepteur : Schéma mécanique

## 11.15. Boitier : Cotation « Top »

## 11.16. Boitier : Cotation « Bottom »

## 11.17. Software : NRF52840 Emetteur

## 11.18. Software : NRF52840 Récepteur

Miguel Santos II

Miguel Santos 27/28

2228 Alarme de fenêtre ouverte
