Miguel-SLO/2228_AlarmeFenetre/2228_AlarmeFenetreOuverte/hard/2228_DesignRuleCheck/2228_AlarmeFenetreOuverte-Recepteur-DesignRuleCheck-V1.html

Altium

# Design Rule Verification Report

Date: | | 11.06.2023
Time: | | 15:58:15
Elapsed Time: | | 00:00:02
Filename: | | C:\Users\migsantos\MIGSAN_GIT\2228_AlarmeFenetre\2_PCB\2228_AlarmeFenetre_Recepteur\22281A_AlarmeFenetre_Recepteur.PcbDoc

Warnings: | | 0
Rule Violations: | | 0

## Summary

Warnings | Count
Total | 0

Rule Violations | Count
Clearance Constraint (Gap=0.151mm) (All),(All) | 0
Short-Circuit Constraint (Allowed=No) (All),(All) | 0
Un-Routed Net Constraint ( (All) ) | 0
Modified Polygon (Allow modified: No), (Allow shelved: No) | 0
Width Constraint (Min=0.15mm) (Max=1.5mm) (Preferred=0.2mm) (All) | 0
Power Plane Connect Rule(Relief Connect )(Expansion=0.175mm) (Conductor Width=0.2mm) (Air Gap=0.2mm) (Entries=4) (All) | 0
Minimum Annular Ring (Minimum=0.175mm) (((ObjectKind = 'Pad') OR (ObjectKind = 'Via')) And (Layer = 'MultiLayer') And (HoleDiameter > AsMM(0.45))) | 0
Minimum Annular Ring (Minimum=0.175mm) (((ObjectKind = 'Pad') OR (ObjectKind = 'Via')) And (Layer = 'MultiLayer') And (HoleDiameter <= AsMM(0.45))) | 0
Hole Size Constraint (Min=0.25mm) (Max=10mm) (All) | 0
Pads and Vias to follow the Drill pairs settings | 0
Hole To Hole Clearance (Gap=0.35mm) (All),(All) | 0
Minimum Solder Mask Sliver (Gap=0.08mm) (All),(All) | 0
Silk To Solder Mask (Clearance=0.2mm) (IsPad),(All) | 0
Silk to Silk (Clearance=0.2mm) (All),(All) | 0
Net Antennae (Tolerance=0mm) (All) | 0
Board Clearance Constraint (Gap=0mm) (All) | 0
Component Clearance Constraint ( Horizontal Gap = 0.25mm, Vertical Gap = 0.25mm ) (All),(All) | 0
Height Constraint (Min=0mm) (Max=25mm) (Prefered=12.5mm) (All) | 0
Total | 0
