Miguel-SLO/2228_AlarmeFenetre/2228_AlarmeFenetreOuverte/doc/Rendu final/2228_NRF_Recepteur-main.pdf

1 /*
2 * ETML-ES
3 *
4 * 2228_AlarmeFenetreOuverte 5 *
6 * Main NRF Récepteur
7 *
8 * Miguel Santos
9 * 2023
10 */
11 #include <zephyr/kernel.h>
12 #include <zephyr/drivers/gpio.h> 13 #include <zephyr/drivers/uart.h> 14
15 /* Main loop sleeping time in ms */
16 | #define SLEEP_TIME_MS 100000
17
18 /* Action sent by uart on PIC32 */ 19 #define ACTION1 0x0F
20
21 /* Devicetree nodes identifiers */ 22 #define LED0_NODE DT_ALIAS(led0) 23 #define LED1_NODE DT_ALIAS(led1) 24 #define LED2_NODE DT_ALIAS(led2) 25 #define LED3_NODE DT_ALIAS(led3)
26 #define SW0_NODE DT_ALIAS(sw0)
27
28 #define UART_NODE DT_NODELABEL(uart0)
29
30 /* GPIO specifications */
31 static const struct gpio_dt_spec led0 = GPIO_DT_SPEC_GET(LED0_NODE, gpios); 32 static const struct gpio_dt_spec led1 = GPIO_DT_SPEC_GET(LED1_NODE, gpios); 33 static const struct gpio_dt_spec led2 = GPIO_DT_SPEC_GET(LED2_NODE, gpios); 34 static const struct gpio_dt_spec led3 = GPIO_DT_SPEC_GET(LED3_NODE, gpios); 35 static const struct gpio_dt_spec btn0 = GPIO_DT_SPEC_GET(SW0_NODE, gpios); 36
37 /* Infos about UART */
38 static const struct device *uart = DEVICE_DT_GET(UART_NODE);
39
40 /* Buffer to store incoming UART data*/
41 static uint8_t rx_buffer[10] = {0};
42
43 /* Infos about btn0 isr callback */
44 static struct gpio_callback btn0_cb_data; 45
46 /* Check if devices are available
47 * if not, programm should be stop */ 48 bool check_devices()
49 {
50 bool device_error = false;
51
52 if (!device_is_ready(led0.port)) { 53 device_error = true;
54 }
55
56 if (!device_is_ready(led1.port)) { 57 device_error = true;
58 }
59
60 if (!device_is_ready(led2.port)) { 61 device_error = true;
62 }
63
64 if (!device_is_ready(led3.port)) { 65 device_error = true;
66 }
67
68 if (!device_is_ready(btn0.port)) { 69 device_error = true;
70 }
71
72 if (!device_is_ready(uart)) { 73 device_error = true;

74 }
75
76 return device_error;
77 }
78
79 /* Configure pins to input or outputs */ 80 bool configure_devices()
81 {
82 bool device_error = false;
83 int device_return;
84
85 device_return = gpio_pin_configure_dt(&led0, GPIO_OUTPUT_INACTIVE); 86 if (device_return < 0) {
87 device_error = true;
88 }
89
90 device_return = gpio_pin_configure_dt(&led1, GPIO_OUTPUT_INACTIVE); 91 if (device_return < 0) {
92 device_error = true;
93 }
94
95 device_return = gpio_pin_configure_dt(&led2, GPIO_OUTPUT_INACTIVE); 96 if (device_return < 0) {
97 device_error = true;
98 }
99
100 device_return = gpio_pin_configure_dt(&led3, GPIO_OUTPUT_INACTIVE); 101 if (device_return < 0) {
102 device_error = true;
103 }
104
105 device_return = gpio_pin_configure_dt(&btn0, GPIO_INPUT); 106 if (device_return < 0) {
107 device_error = true;
108 }
109
110 return device_error;
111 }
112
113 /* Callback function of btn0 ISR */
114 void btn0_cb(const struct device *dev, struct gpio_callback *cb, uint32_t pins) 115 {
116 if(gpio_pin_get_dt(&btn0))
117 {
118 gpio_pin_set_dt(&led0, true); 119 }
120 else
121 {
122 gpio_pin_set_dt(&led0, false); 123 }
124 }
125
126 /* Configure interrupt service routine */ 127 bool btn0_configure_isr()
128 {
129 bool int_return;
130
131 /* Assign an interrupt to a pin and trigger edge */
132 int_return = gpio_pin_interrupt_configure_dt(&btn0, GPIO_INT_EDGE_BOTH); 133
134 /* Initialize the static struct gpio_callback variable */
135 gpio_init_callback(&btn0_cb_data, btn0_cb, BIT(btn0.pin));
136
137 | /* Add the callback function by calling gpio_add_callback() */
138 gpio_add_callback(btn0.port, &btn0_cb_data);
139
140 return int_return;
141 }
142
143 static void uart_cb(const struct device *dev, struct uart_event *evt, void *user_data) 144 {
145 switch (evt->type) {
146 case UART_TX_DONE:

147 // do something
148 break;
149 case UART_TX_ABORTED:
150 // do something
151 break;
152 case UART_RX_RDY:
153 if(evt->data.rx.buf[evt->data.rx.offset] == ACTION1) 154 {
155 gpio_pin_toggle_dt(&led1);
156 }
157 break;
158 case UART_RX_BUF_REQUEST:
159 // do something
160 break;
161 case UART_RX_BUF_RELEASED: 162 // do something
163 break;
164 case UART_RX_DISABLED:
165 uart_rx_enable( uart, rx_buffer, sizeof(rx_buffer), 100); 166 break;
167 case UART_RX_STOPPED:
168 // do something
169 break;
170 default:
171 break;
172 }
173 }
174
175 void main(void)
176 {
177 bool error_return;
178
179 /* Check if devices are configured right */ 180 error_return = check_devices();
181 if(error_return){
182 return;
183 }
184
185 /* Configure GPIO to input or output */ 186 error_return = configure_devices(); 187 if(error_return){
188 return;
189 }
190
191 /* Configure UART callback routine */
192 error_return = uart_callback_set(uart, uart_cb, NULL); 193 if (error_return) {
194 return;
195 }
196
197 /* Enable UART */
198 uart_rx_enable(uart ,rx_buffer ,sizeof(rx_buffer) ,100); 199
200 /* Configure interrupt related to btn0*/
201 btn0_configure_isr();
202
203 while (true) {
204 k_msleep(SLEEP_TIME_MS); 205 }
206 }
207
