Miguel-SLO/2228_AlarmeFenetre/2228_AlarmeFenetreOuverte/doc/Datasheets/bq25505SolarAppDesign_V1p3.xlsx

User Input
Computed/Fixed
 |  |  | VSTOR nominal | 2.00 | V |  |  |  |  | VBAT_UV < VSTOR nominal <= VBAT_OV
System Loads | VOUT (V) | IOUT (mA) | Est Buck Effcy per datasheet | ISTOR = (VOUTxIOUT) / (VSTORnom x Effcy) (mA) | Mode Duration (how long?) (s) | Mode Period (how often?) (s) | Mode Hours / Day = 24 hours x duration/ period | mAHr / Day = ISTOR X Mode Hrs / Day | mWHr / Day = VSTOR x mAHr / Day
Active Mode 1 - TPS62736 VOUT | 3.300 | 20.000 | 0.800 | 41.250
Active Mode 1 - bq25505 VSTOR |  |  |  | 0.000 |  |  |  |  |  | Direct loading on VSTOR
Totals for Active Mode 1 |  |  |  | 41.250 | 30.000 | 86400.000 | 0.008 | 0.344 | 0.688
Active Mode 2 - TPS62736 VOUT | 1.800 | 0.000 | 0.850 | 0.000 |  |  |  |  |  | If only one active mode, enter 0 for IOUT.
Active Mode 2 - bq25505 VSTOR |  |  |  | 0.000 |  |  |  |  |  | If only one active mode, enter 0 for ISTOR.
Totals for Active Mode 2 |  |  |  | 0.000 | 0.125 | 60.000 | 0.050 | 0.000 | 0.000
Sleep Mode - bq25505 VSTOR (1.8V rail off) |  |  |  | 0.010 |  |  | 23.942 | 0.239 | 0.479 | Idle mode hours / day = 24 minus active mode hours / day
bq25505 Iq + TPS62736 Iq + storage element leakage current |  |  |  | 0.001 |  |  | 24.000 | 0.024 | 0.048 | Storage element leaks all the time.
 | Total mAHr / day consumed |  |  |  |  |  |  | 0.607 | mAHr / day
 | Multiply by max consec dark days (e.g. not charging when overcast or raining) |  |  |  |  |  |  | 1.000 | days / week
 | Recommended minimum battery capacity |  |  |  |  |  |  | 0.607 | mAHr
 | -OR-
 | Mininum super capacitor voltage |  |  |  |  |  |  | 2.000 | V | VBAT_UV = 2.0V > Min super capacitor > VSTOR nominal
 | Maximum super capacitor voltage |  |  |  |  |  |  | 3.000 | V | VSTOR nominal < Max super capacitor voltage <= VBAT_OV
 | Recommended minimum super capacitance |  |  |  |  |  |  | 1.749 | F | Min Bat Capacity / 1000 x 3600s/hr x VSTORNOM = 1/2 x CSUPER x (Vmax2 - Vmin2)
 |  | Total mWHr / day consumed |  |  |  |  |  |  | 1.214 | mWHr / day
 |  | Multiply by operating days per week |  |  |  |  |  |  | 7.000 | days / week
 |  | Total mWHr /week required for system operation for the week |  |  |  |  |  |  | 8.500 | mWHr / week
 |  | Divide by charging days per week |  |  |  |  |  |  | 6.000 | days / week | Operating days minus max consecutive dark days
 |  | Total mWHr / day required to be collected by solar panel during charging days |  |  |  |  |  |  | 1.417 | mWHr / day | Total 7-day power must be collected during 5 charging days
 |  | Divide by charging hours / day |  |  |  |  |  |  | 8.000 | hours / day | i.e., includes excess energy for charging the battery
 |  | Instantaneous power required from the solar panel |  |  |  |  |  |  | 0.177 | mW
 |  |  | Divide by low estimate of bq25505 efficiency per datasheet |  |  |  |  |  | 0.800
 |  |  | Minimum input power required for system operation |  |  |  |  |  | 0.221 | mW
 |  |  |  | Divide by panel power per panel datasheet |  |  |  |  | 8.000 | mW/cm2 | Use power from lowest expected light level
 |  |  |  | Minimum solar panel area required |  |  |  |  | 0.028 | cm2
