Miguel-SLO/2228_AlarmeFenetre/2228_AlarmeFenetreOuverte/doc/1_Design/Presentation_Design.pptx

## Présentation de design

2228
Alarme de fenêtre ouverte

Miguel Santos

1er février 2023

## Schéma-bloc émetteur

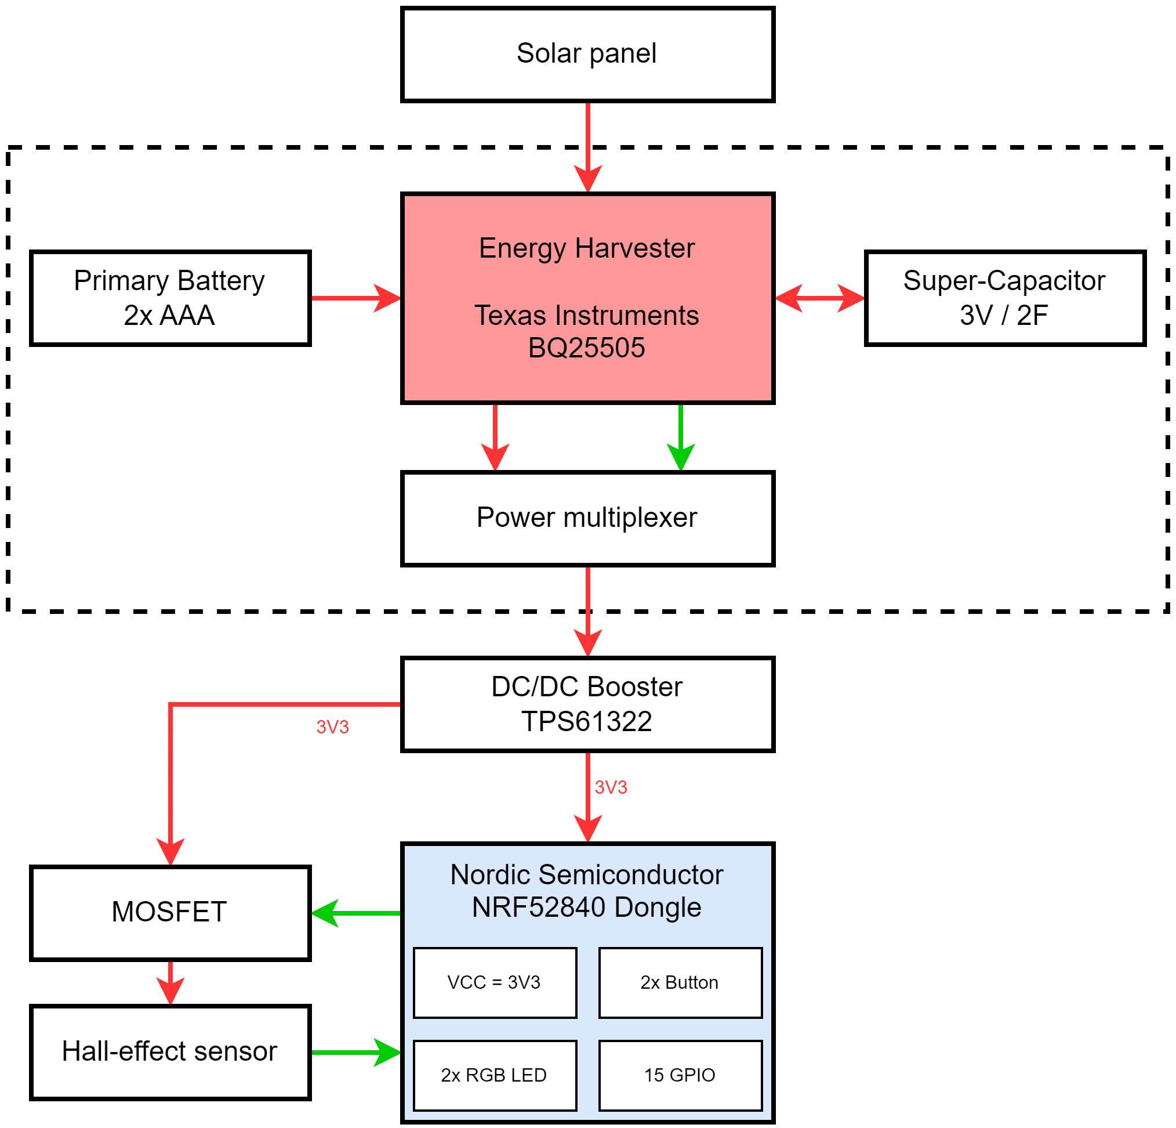
[picture p146: figure]

## Slide 3

BQ25505

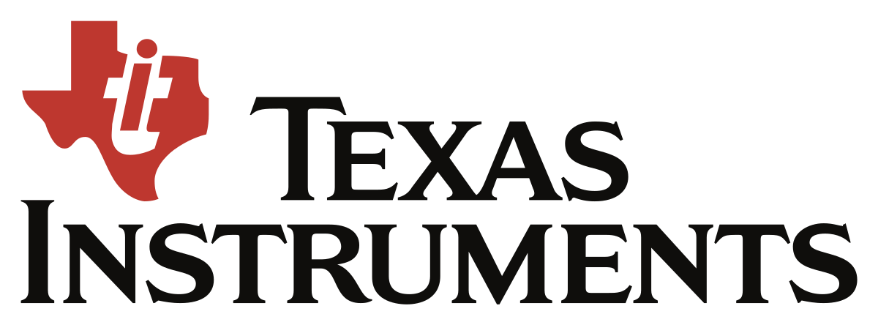
[picture p147: figure]
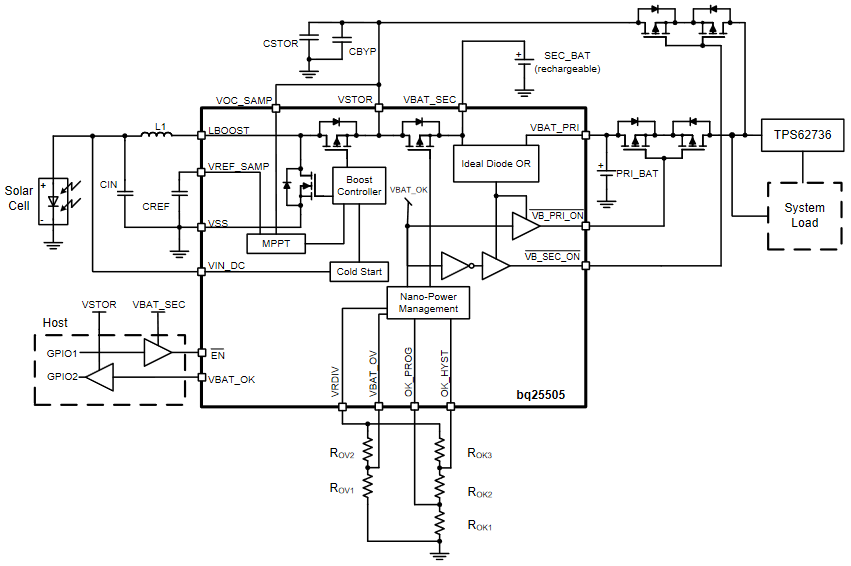
[picture p148: figure]
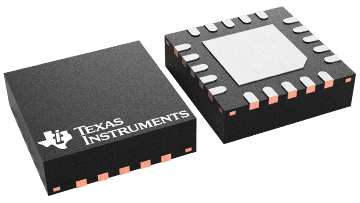
[picture p149: figure]
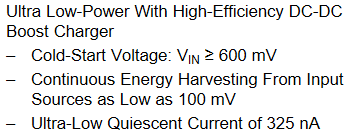
[picture p150: figure]

## Slide 4

KXOB25-05X3F

- Monocristallin
- Haute efficacité
- Taille réduite
- Montage en surface

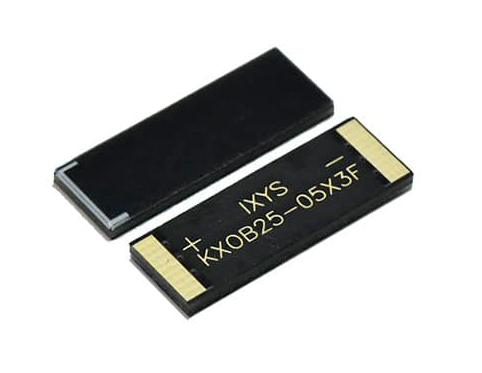
[picture p151: figure]
KXOB25-05X3F
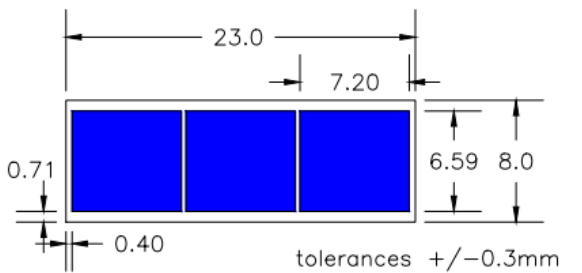
[picture p152: figure]

## Slide 5

TPS612322

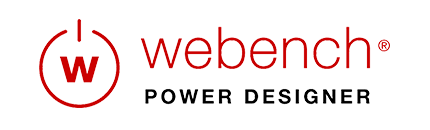
[picture p153: figure]
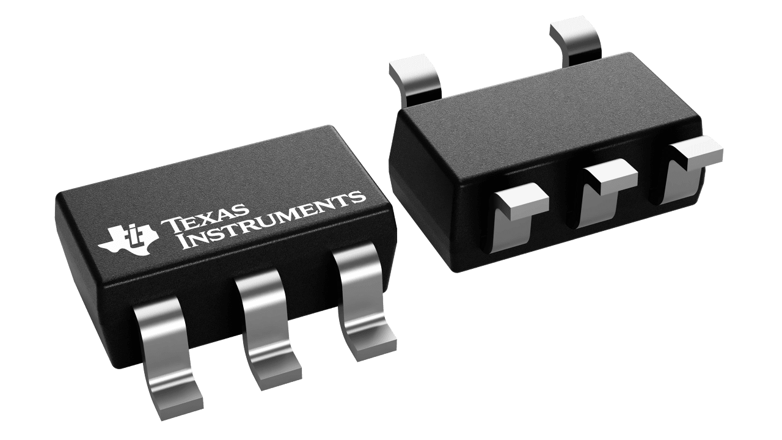
[picture p154: figure]
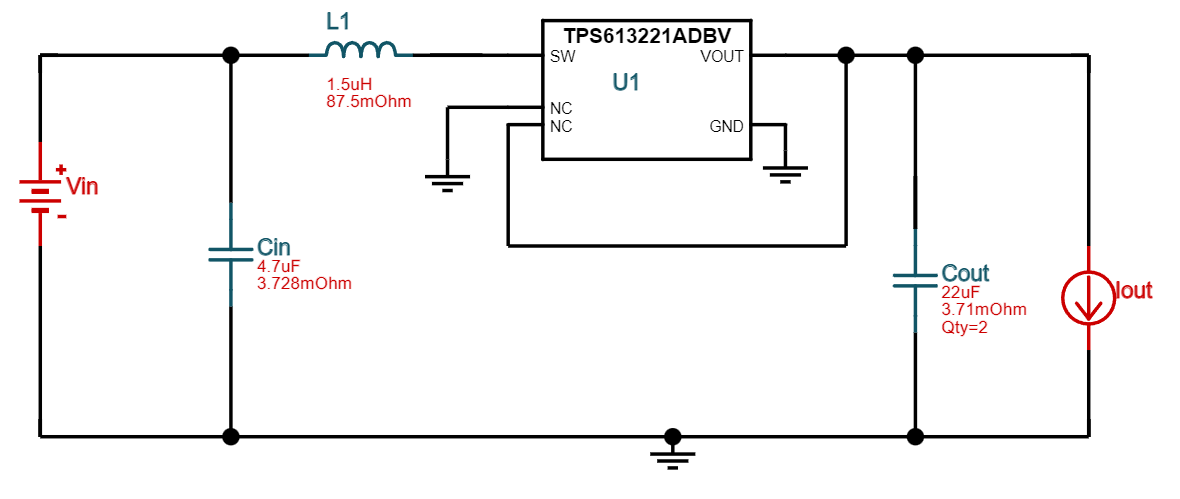
[picture p155: figure]

## Slide 6

Schéma d’alimentation

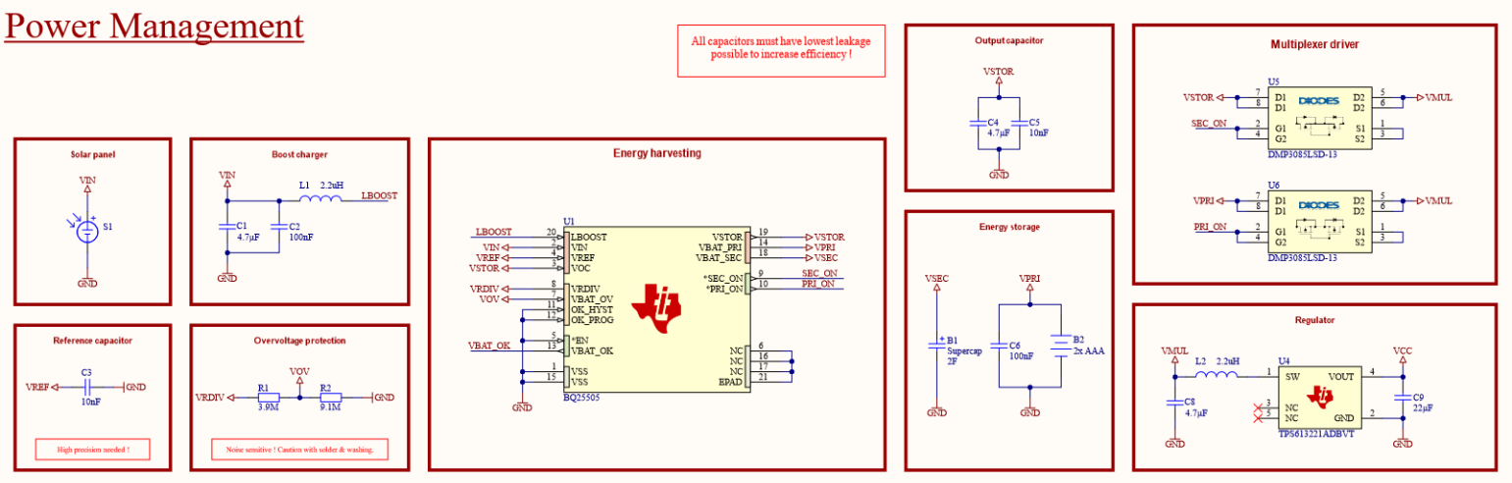
[picture p156: figure]

## Slide 7

NRF52840-DONGLE

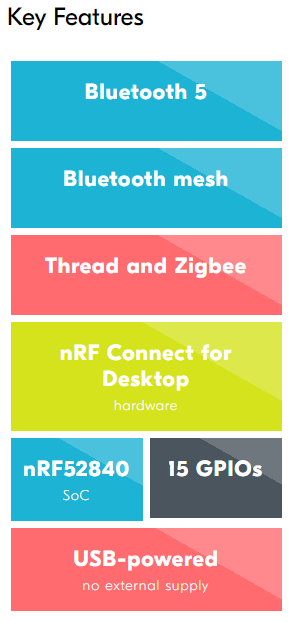
[picture p157: figure]
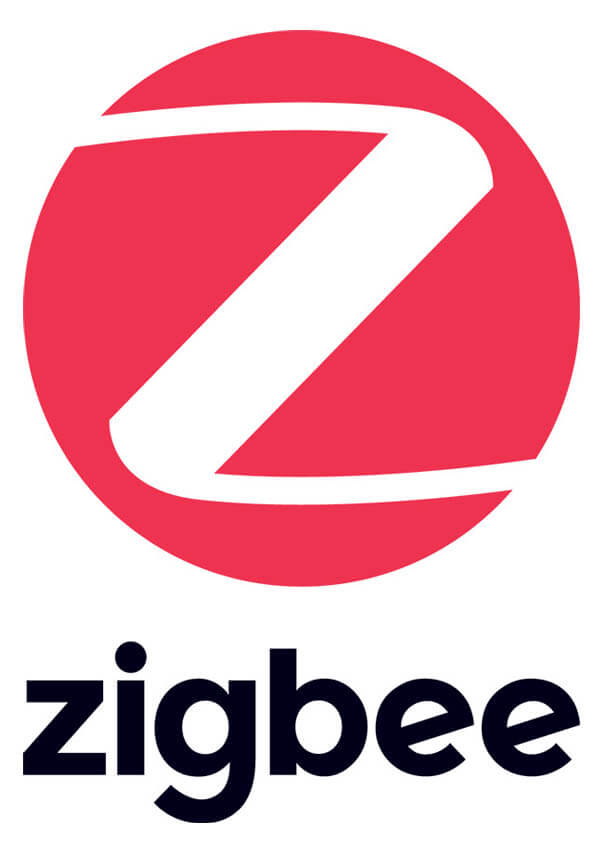
[picture p158: figure]
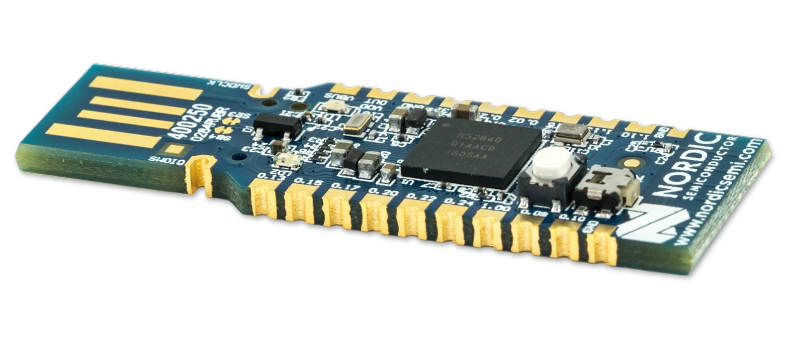
[picture p159: figure]

## Slide 8

DRV5032

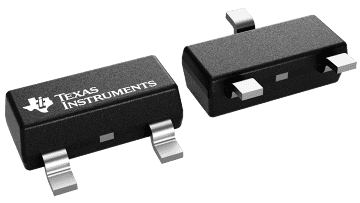
[picture p160: figure]
Functional Block
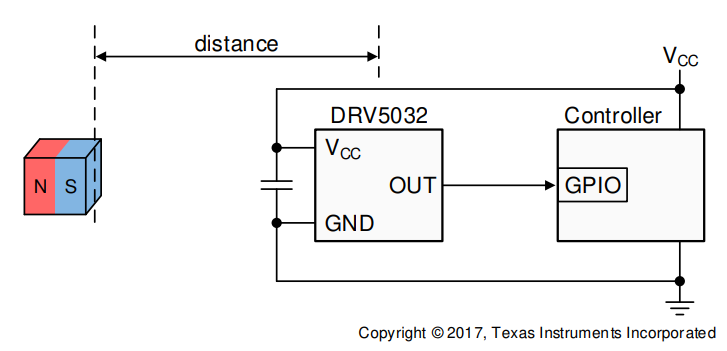
[picture p161: figure]
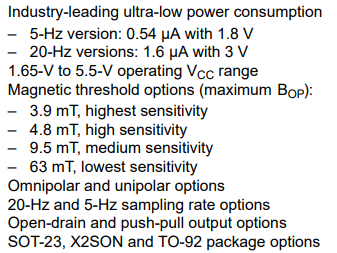
[picture p162: figure]

## Slide 9

Capteur à effet hall et NRF52840

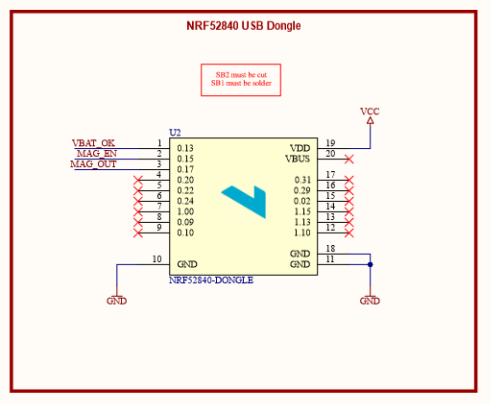
[picture p163: figure]
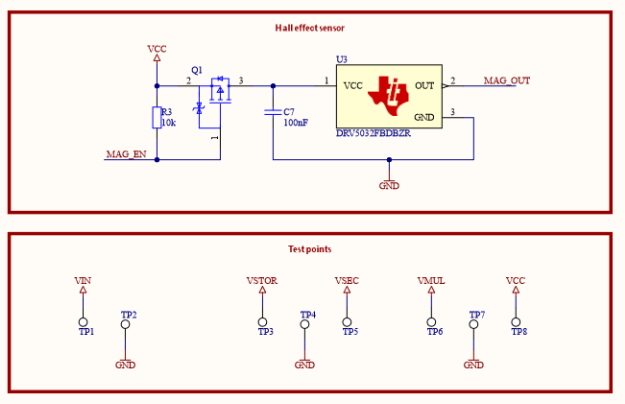
[picture p164: figure]

## Schéma-bloc récepteur

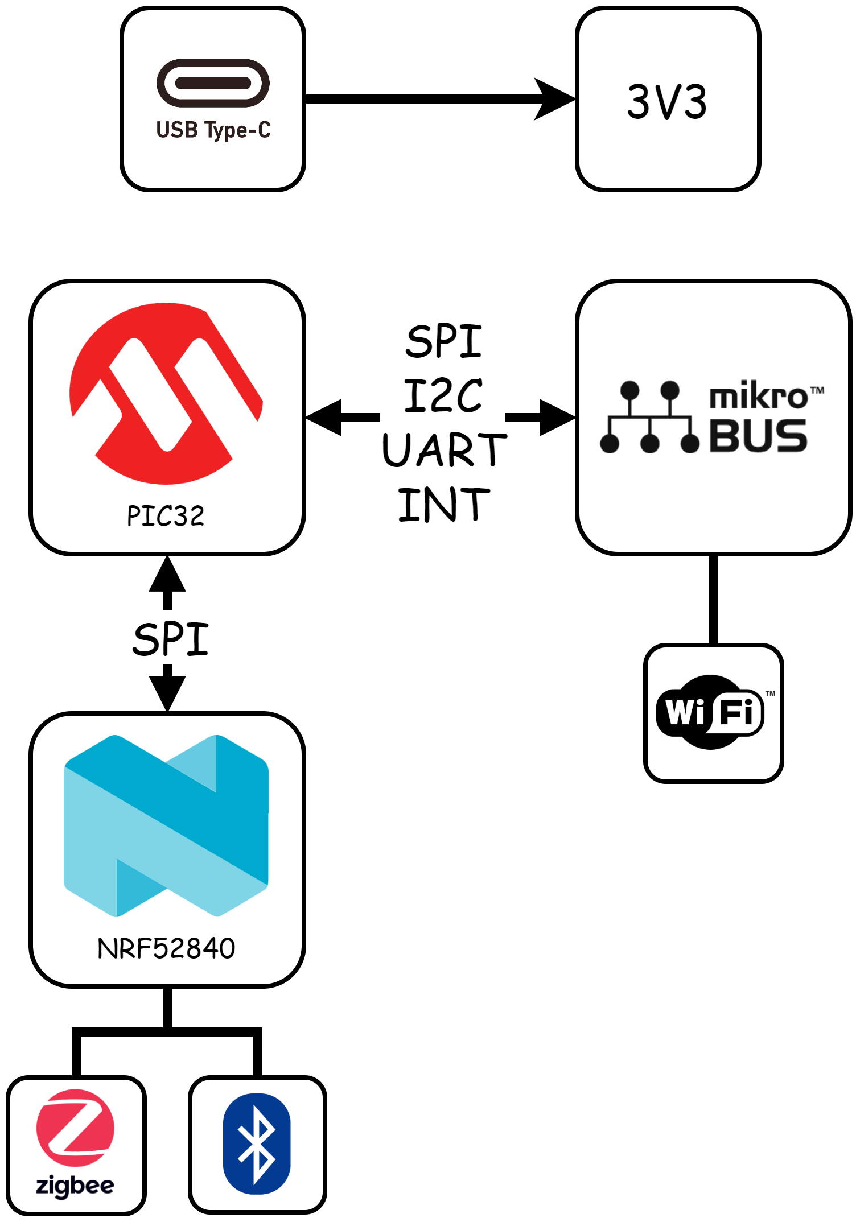
[picture p165: figure]

## Slide 11

Schéma récepteur

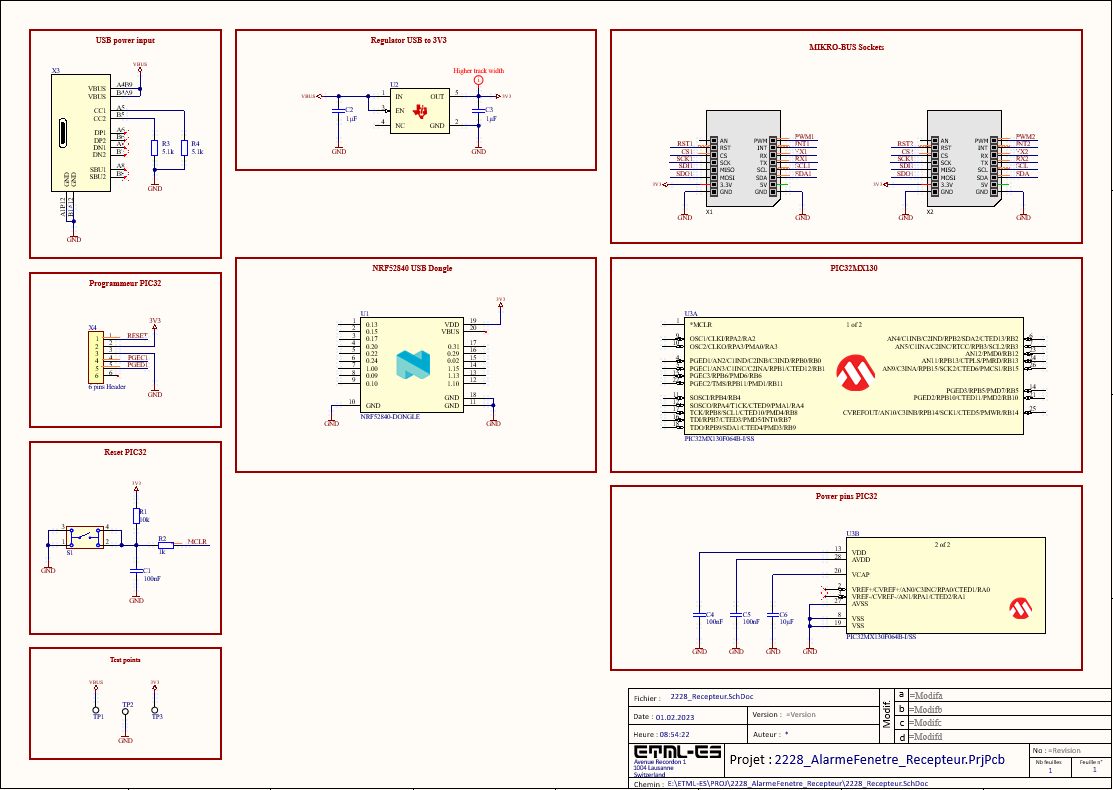
[picture p166: figure]

## Perspectives

- Prototype de l’émetteur
- Essais sur le NRF52840 avec code d’exemples
- Recherche de modules MIKROE pour récepteur
- Développement du récepteur

## Questions ?
