Miguel-SLO/2228_AlarmeFenetre/2228_AlarmeFenetreOuverte/doc/Captures/2228_PCB_Recepteur_3D.png

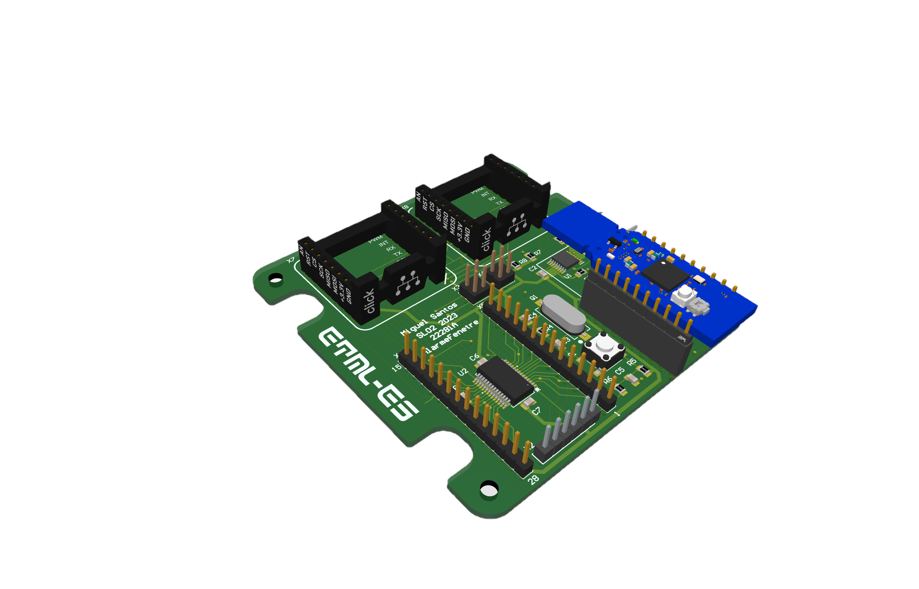
2228_AlarmeFenetreOuverte/doc/Captures/2228_PCB_Recepteur_3D.png
