Miguel-SLO/2228_AlarmeFenetre/2228_AlarmeFenetreOuverte/doc/Captures/pining_nrfDongle.PNG

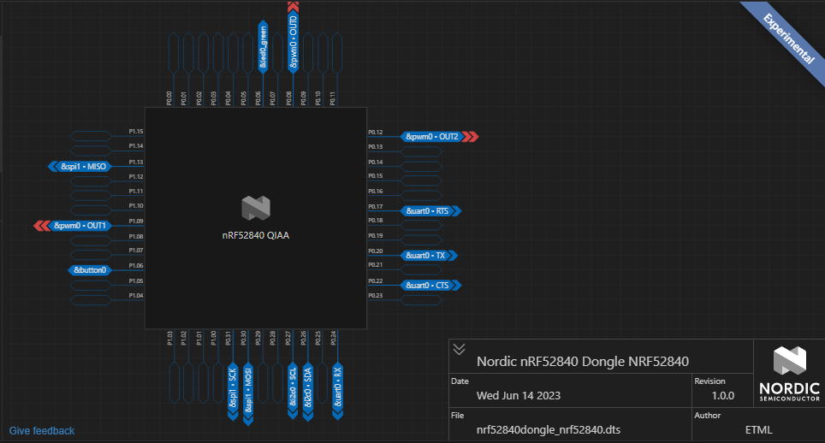
2228_AlarmeFenetreOuverte/doc/Captures/pining_nrfDongle.PNG
