Miguel-SLO/2228_AlarmeFenetre/PINOUT_PIC32.PNG

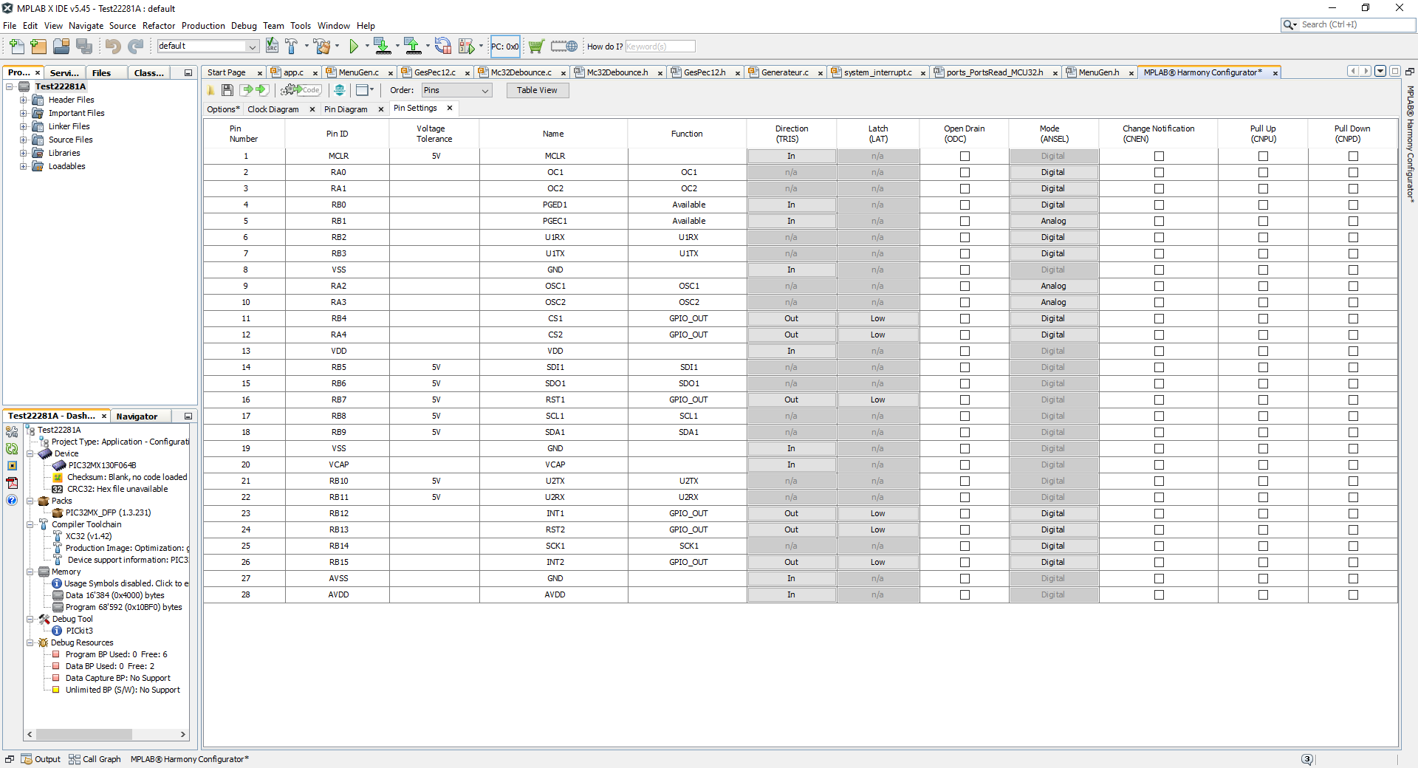
PINOUT_PIC32.PNG
