Miguel-SLO/2228_AlarmeFenetre/2228_AlarmeFenetreOuverte/hard/2228_Altium/2228_AlarmeFenetreOuverte-BOM-TEMPLATE.xlsx

ETML-ES |  |  | Bill of materials
Name of project : |  | Alarme pour fenêtre ouverte |  |  | Author : | Miguel Santos |  | PCB : | A
N° of project : |  | 2228 |  |  | Date : | 2023-06-13 |  | Version : | 1.0
Column=Description | Column=Designator | Column=Value | Column=Quantity | Column=Manufacturer 1 | Column=Manufacturer Part Number 1 | Column=Supplier 1 | Column=Supplier Part Number 1 | Column=In stock | Remarks
