Miguel-SLO/2228_AlarmeFenetre/2228_AlarmeFenetreOuverte/mec/2228_Emetteur-Bottom/2228_Emetteur_Bottom.SLDPRT

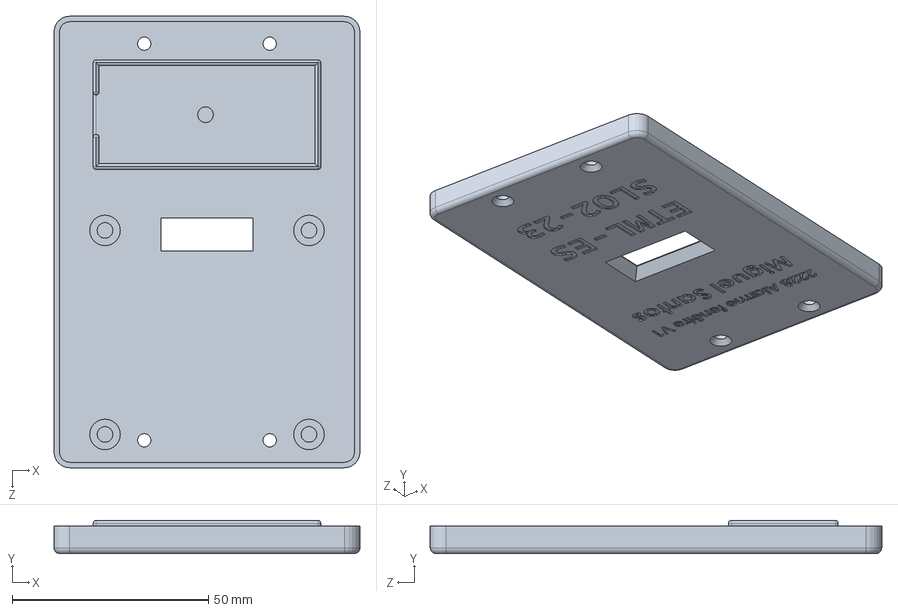
[picture p172: CAD file, 2023-06-13]
2228_AlarmeFenetreOuverte/mec/2228_Emetteur-Bottom/2228_Emetteur_Bottom.SLDPRT
78.0 x 8.50 x 115.1 mm
