Miguel-SLO/2228_AlarmeFenetre/2228_AlarmeFenetreOuverte/mec/2228_Emetteur-Top/2228_Emetteur_Top.SLDPRT

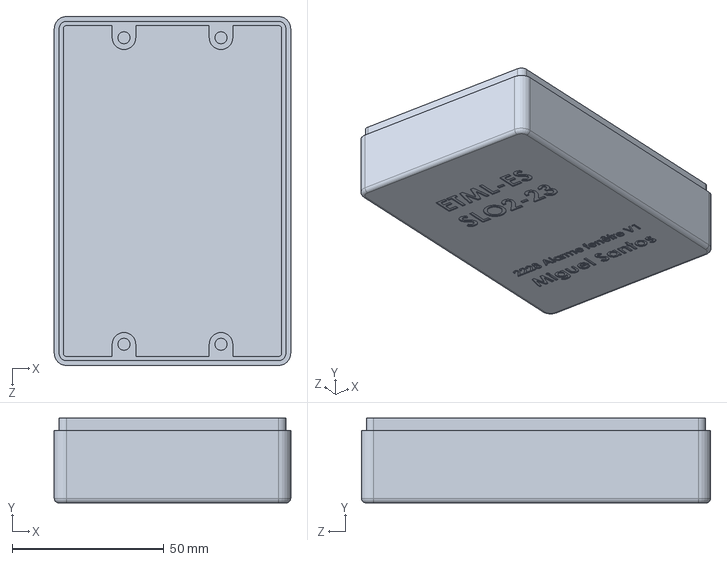
[picture p174: CAD file, 2023-06-13]
2228_AlarmeFenetreOuverte/mec/2228_Emetteur-Top/2228_Emetteur_Top.SLDPRT
78.0 x 28.0 x 115.1 mm
