Miguel-SLO/2228_AlarmeFenetre/2228_AlarmeFenetreOuverte/mec/2228_Emetteur-External/keystone-PN2469.step.SLDPRT

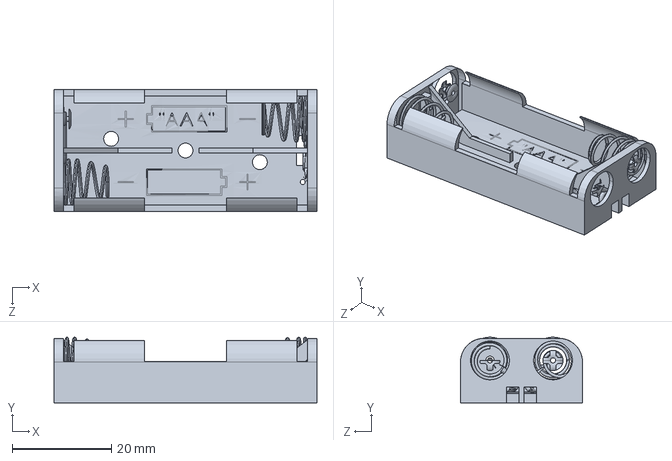
[picture p175: CAD file, 2023-03-29]
2228_AlarmeFenetreOuverte/mec/2228_Emetteur-External/keystone-PN2469.step.SLDPRT
53.0 x 13.2 x 24.6 mm
