Miguel-SLO/2228_AlarmeFenetre/(list of files, cad)

Other CAD files:
2228_AlarmeFenetreOuverte/mec/2228_Emetteur-Bottom/2228_Emetteur-Bottom-V1.STL
2228_AlarmeFenetreOuverte/mec/2228_Emetteur-Bottom/2228_Emetteur_Bottom.SLDDRW
2228_AlarmeFenetreOuverte/mec/2228_Emetteur-Top/2228_Emetteur_Top.SLDDRW
2228_AlarmeFenetreOuverte/mec/2228_Emetteur-Top/2228_Emetteur_Top.STL
