Miguel-SLO/2228_AlarmeFenetre/2228_AlarmeFenetreOuverte/doc/2228_JournalDeTravail.xlsx

ETML-ES |  | Journal de travail
2228 |  | AlarmeFenetreOuverte
2023-06-15 |  | Miguel Santos
Date | Étape | Tâches réalisées | Tâches à faire
2023-02-01 | Design | Configuration de l'active BOM | Ajout des footprints manquants
 |  | Ajout des capacités et résistances dans la BOM | Changement du régulateur 3V3
 |  | Changement du connecteur USB
 |  | Ajout des fabricants et MPN à la BOM
 |  | Calculs des ponts résisistifs
2023-02-05 | Design | Correction erreur USB (schéma + footprint) | Vérifier les disponibilités en stock
 |  | Ajout de différents composants à la BOM | Demander pour courants de fuite sur le mosfet
 |  | MAJ Footprint du multiplexer
 |  | Etude de l'application note du BQ25505
2023-02-08 | Design | Changement des valeurs de résistances pour du standard | Confirmer le footprint du BQ25505 (pad thermique)
 |  | Footprint panneau solaire + 3D
 |  | Footprint BQ25505
 |  | Réorganisation du schéma - Séparation en deux schémas - Merge des blocs pour plus de lisibilité - Ajout des jumpers de bypass
2023-02-22 | Design | Footprints des composants passifs | Sérigraphie jumpers
 |  | Fooprint NRF52840 + 3D | Vérification pins NRF
2023-03-01 | Design | Finitions des footprints
 |  | Recherche du boitier
2023-03-02 | Design | Recherche d'un boitier - Boitier 3D décidé ! | Finir le schéma du récepteur
 |  |  | Modification footprint BQ25505
2023-03-04 | Réalisation | Placement des composants sur le PCB de l'émetteur | Vérifier le bornier de piles
 |  | Backup du projet ! | Trous de passage des colonettes du boitier
 |  |  | Sérigraphie info du projet
 |  |  | Sérigraphie d'avertissement de l'alim du NRF
 |  |  | Review du placement émetteur
2023-03-05 | Réalisation | Review du placement par Alexandre
 |  | Routage de l'émetteur - Design rules check OK !
2023-03-08 | Réalisation | Correction du PCB émetteur - Trous de fixation - Ecart avec les jumpers
 |  | Correction footprints
 |  | Correction schéma récepteur
2023-03-14 | Réalisation | Ajouts footprints récepteur - MIKROE - PIC32 + quartz - etc… | Boitier émetteur
 |  | Vérification finale émetteur - Pas d'erreur Altium ni EC !
2023-03-15 | Réalisation | Boitier émetteur terminé | Placement et routage du récepteur
 |  | Réalisation du panel avec émetteur + commande
 |  | Configuration pour conversion automatique de l'active BOM en commande Saphir
 |  | Réalisation active BOM + commande
2023-03-16 | Réalisation | Placement du récepteur (80%)
2023-03-18 | Réalisation | Placement du récepteur terminé | Demander influence de l'oscillateur sur l'UART proche
 |  | Routage du récepteur terminé | Demander pour les polygons et tailles de pistes
2023-03-29 | Réalisation | Boitier émetteur recommencé - Ajout support de pile - Ajout texte info projet - Assemblage virtuel
 |  | Envois fichiers 3D à Mr. Muller
2023-04-26 | Montage | Montage du 1er émetteur terminé
2023-05-03 | Montage | Recherche des raisons des erreurs de fonctionnement
 |  | Analyse du datasheet du BQ25505
2023-05-10 | Montage | Montage du récepteur terminé | Installation environnements de programmation NRF
 |  | Montage du 2eme émetteur terminé
 |  | Tests de fonctionnement du récepteur
 |  | Commande en urgence de panneaux solaire détruits lors du montage (température trop haute)
2023-05-17 | Software | Installation environnement de programmation NRF - NRF Connect - NRF SDK
 |  | Création du projet dans VS Code
2023-05-20 | Software | Etude du fonctionnement du SDK de Nordic
2023-05-21 | Software | Création d'une application basique avec les GPIO
2023-05-23 | Software | Tentative de créer une application Zigbee - Beaucoup d'erreurs de compilation, trop complexe à débugger
2023-05-24 | Software | Création d'une application bluetooth à partir d'exemple fourni - Communication réussie !
2023-05-27 | Software | Configuration Harmony, pins et drivers PIC32 du récepteur
2023-05-31 | Software | Tentative de créer une application Zigbee sur le NRF - Échoué ! -> Utiliser BT
2023-06-07 | Software | Création des projets NRF pour l'émetteur et le récepteur
 | Software | Configuration des différents GPIO nécessaires au NRF et programme
2023-06-12 | Rapport | Organisation de la documentation et dossiers
2023-06-14 | Software | Finalisation des différents programmes NRF et PIC32 pour le récepteur et émetteur
2023-06-14 | Rapport | Ecriture du rapport et différents documents demandés
