Miguel-SLO/2228_AlarmeFenetre/Rendu final/2228_AlarmeFenetreOuverte-Emetteur-Dimensions-V1.pdf

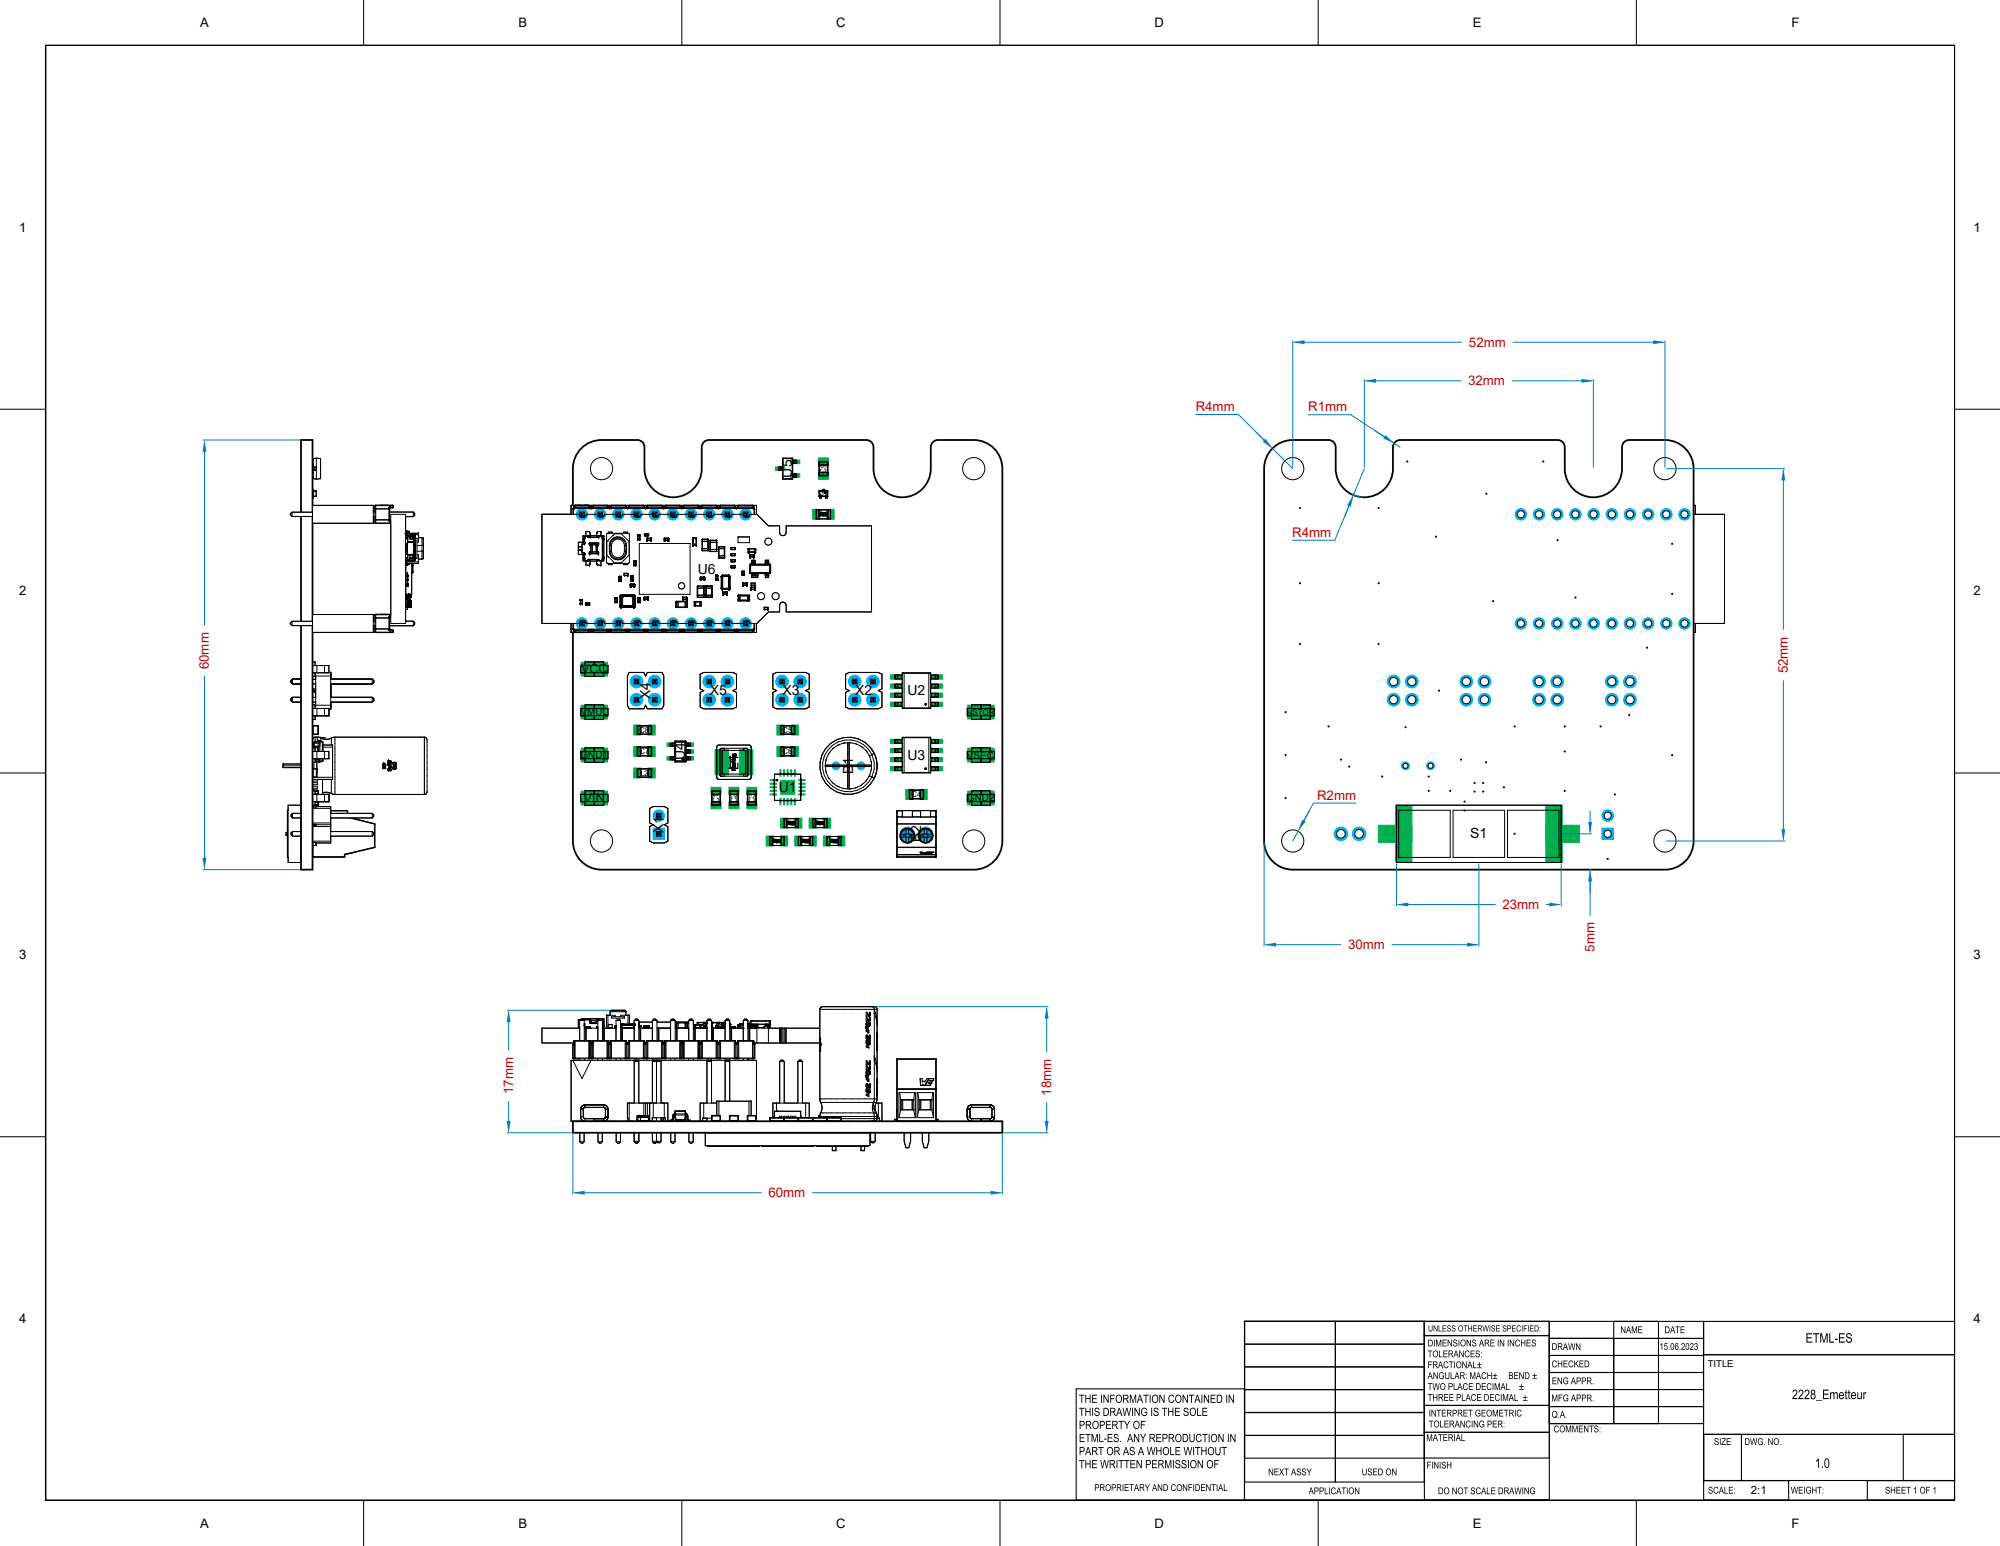
[picture p176: page 1]
