Miguel-SLO/2228_AlarmeFenetre/Rendu final/2228_AlarmeFenetreOuverte-Recepteur-Dimensions-V1.PDF

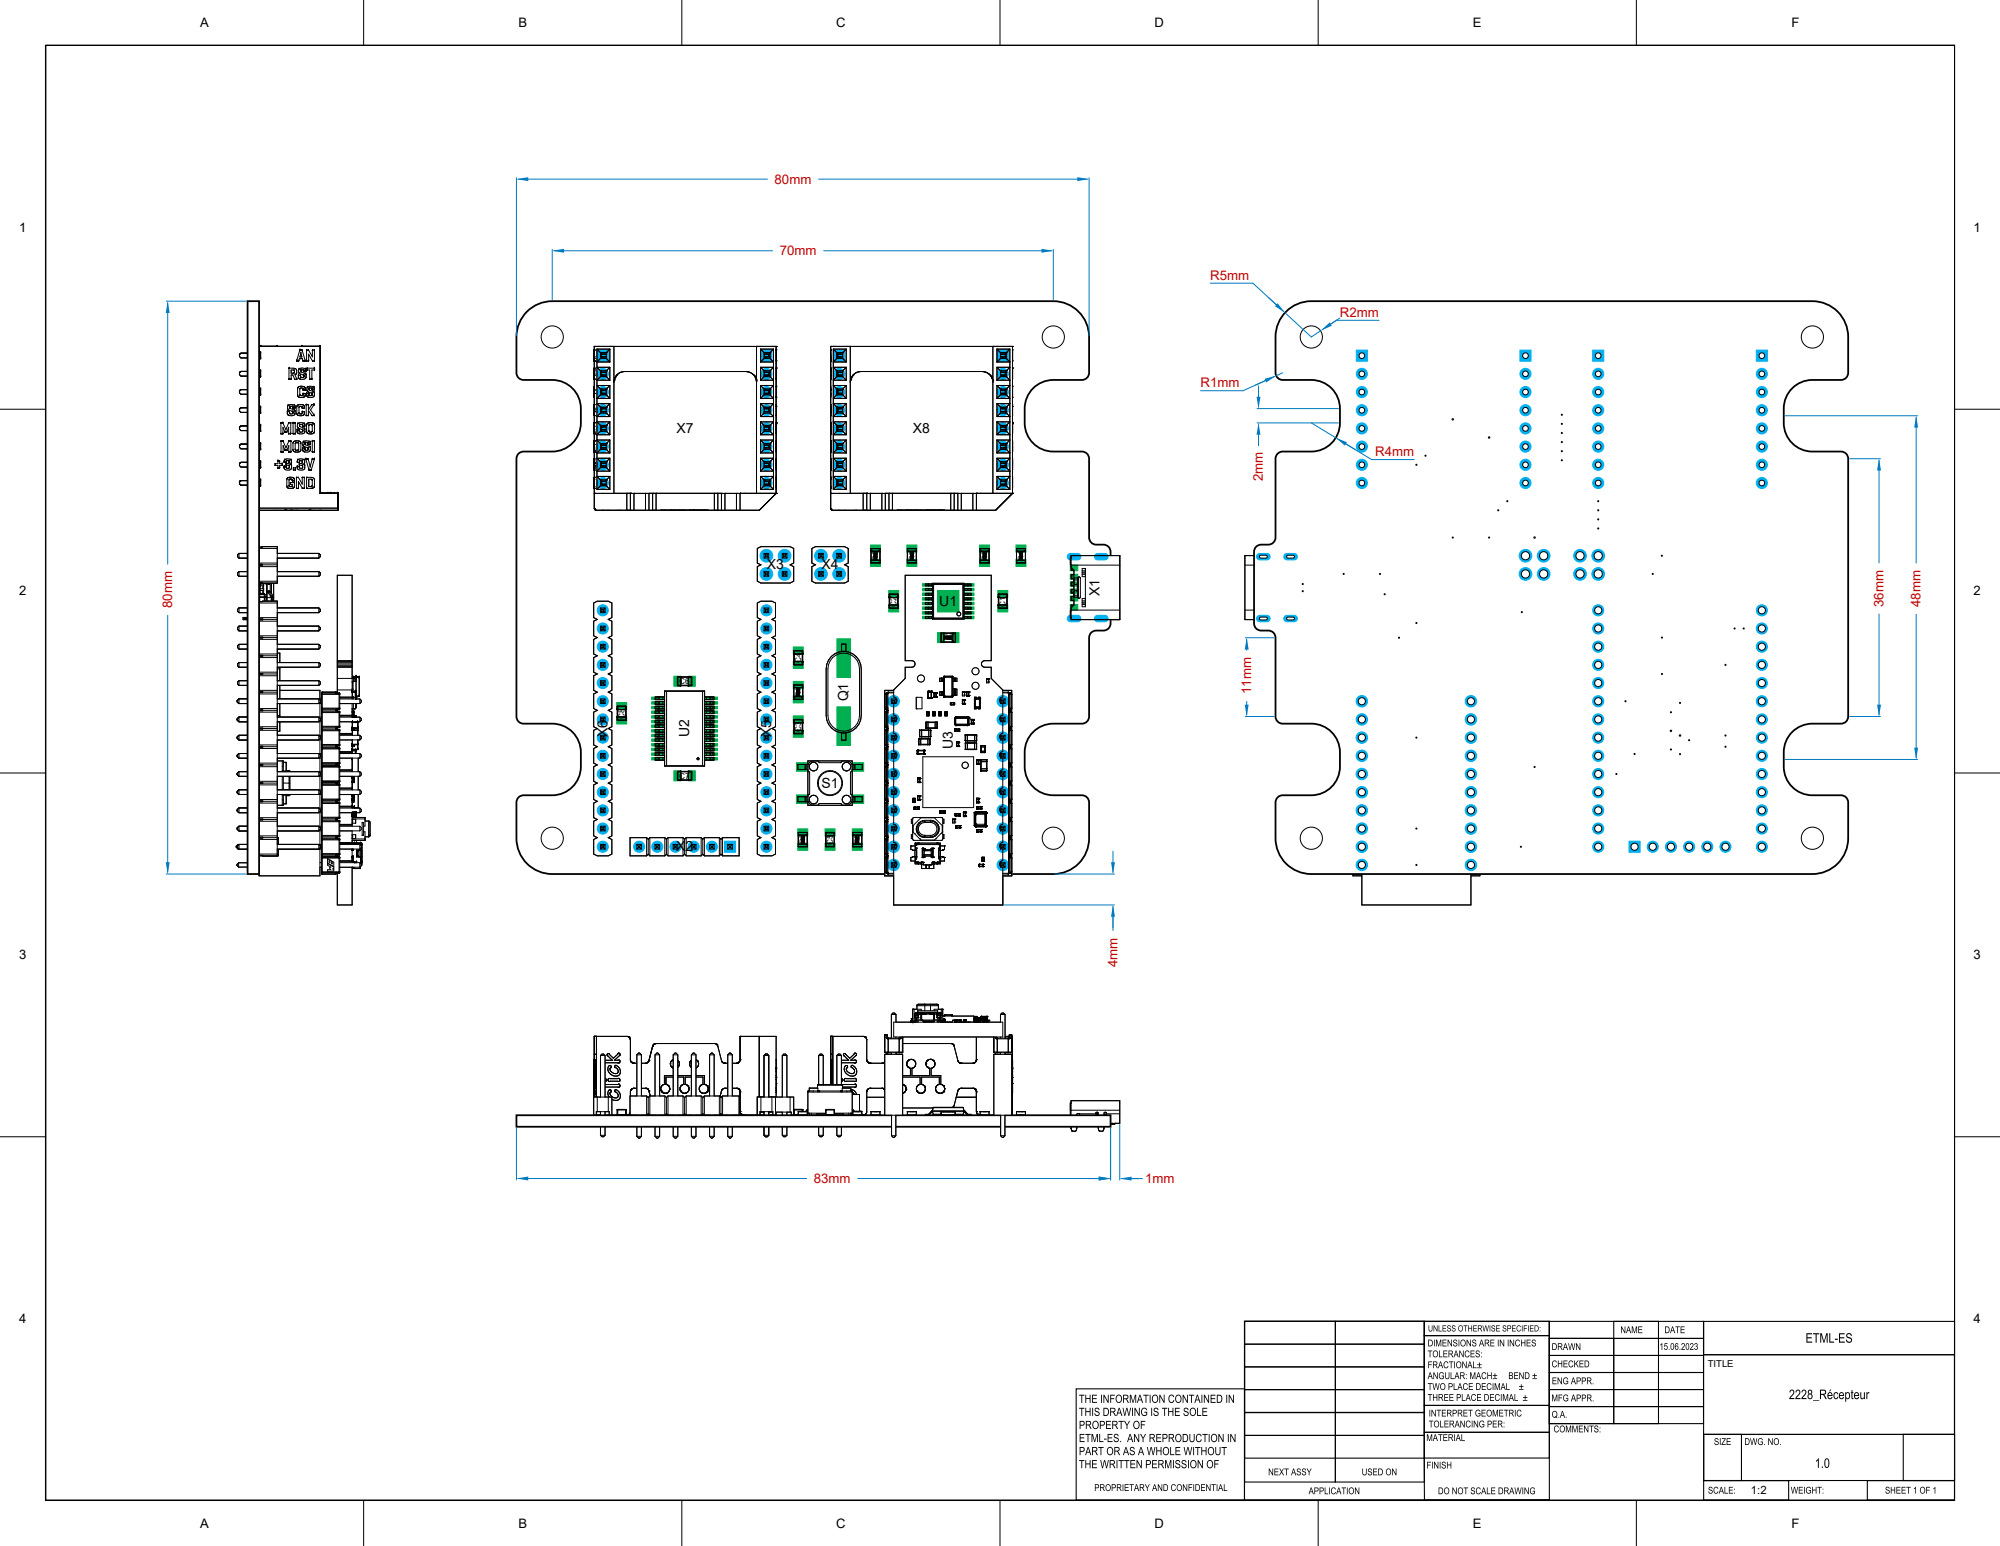
[picture p177: page 1]
