Miguel-SLO/2228_AlarmeFenetre/Rendu final/2228_Emetteur_Bottom.pdf

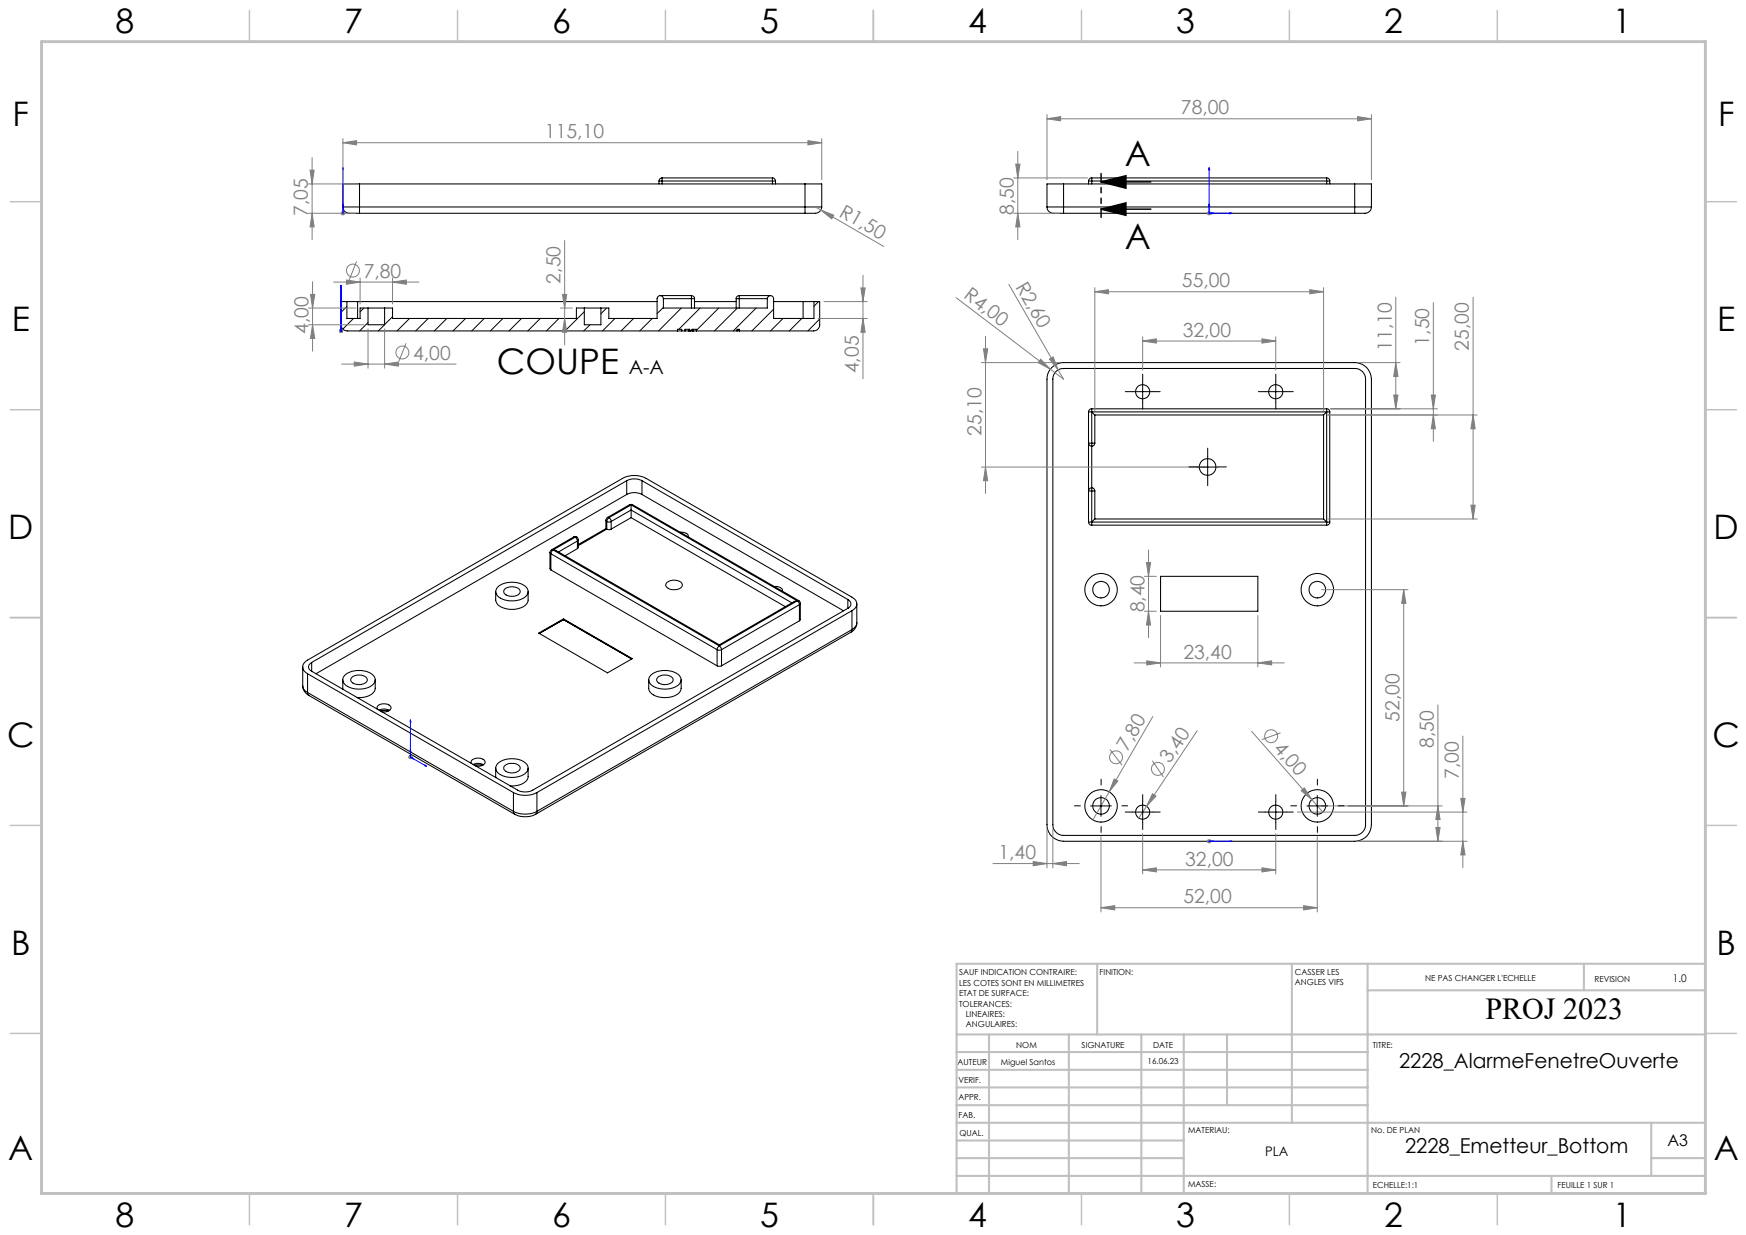
[picture p178: page 1]
COUPE A-A; FINITION:; CASSER LES; ANGLES VIFS; NE PAS CHANGER L'ECHELLE; REVISION; ECHELLE:1:1; FEUILLE 1 SUR 1; PROJ 2023

SAUF INDICATION CONTRAIRE:
LES COTES SONT EN MILLIMETRES
ETAT DE SURFACE:
TOLERANCES:
LINEAIRES:
ANGULAIRES:

NOM | SIGNATURE | DATE | | | | TITRE: 2228_AlarmeFenetreOuverte

AUTEUR | Miguel Santos | | 16.06.23
VERIF.
APPR.
FAB.
QUAL. | | | | MATERIAU: PLA | No. DE PLAN 2228_Emetteur_Bottom | A3
