Miguel-SLO/2228_AlarmeFenetre/Rendu final/2228_AlarmeFenetreOuverte-Emetteur-PCB-V1.PDF

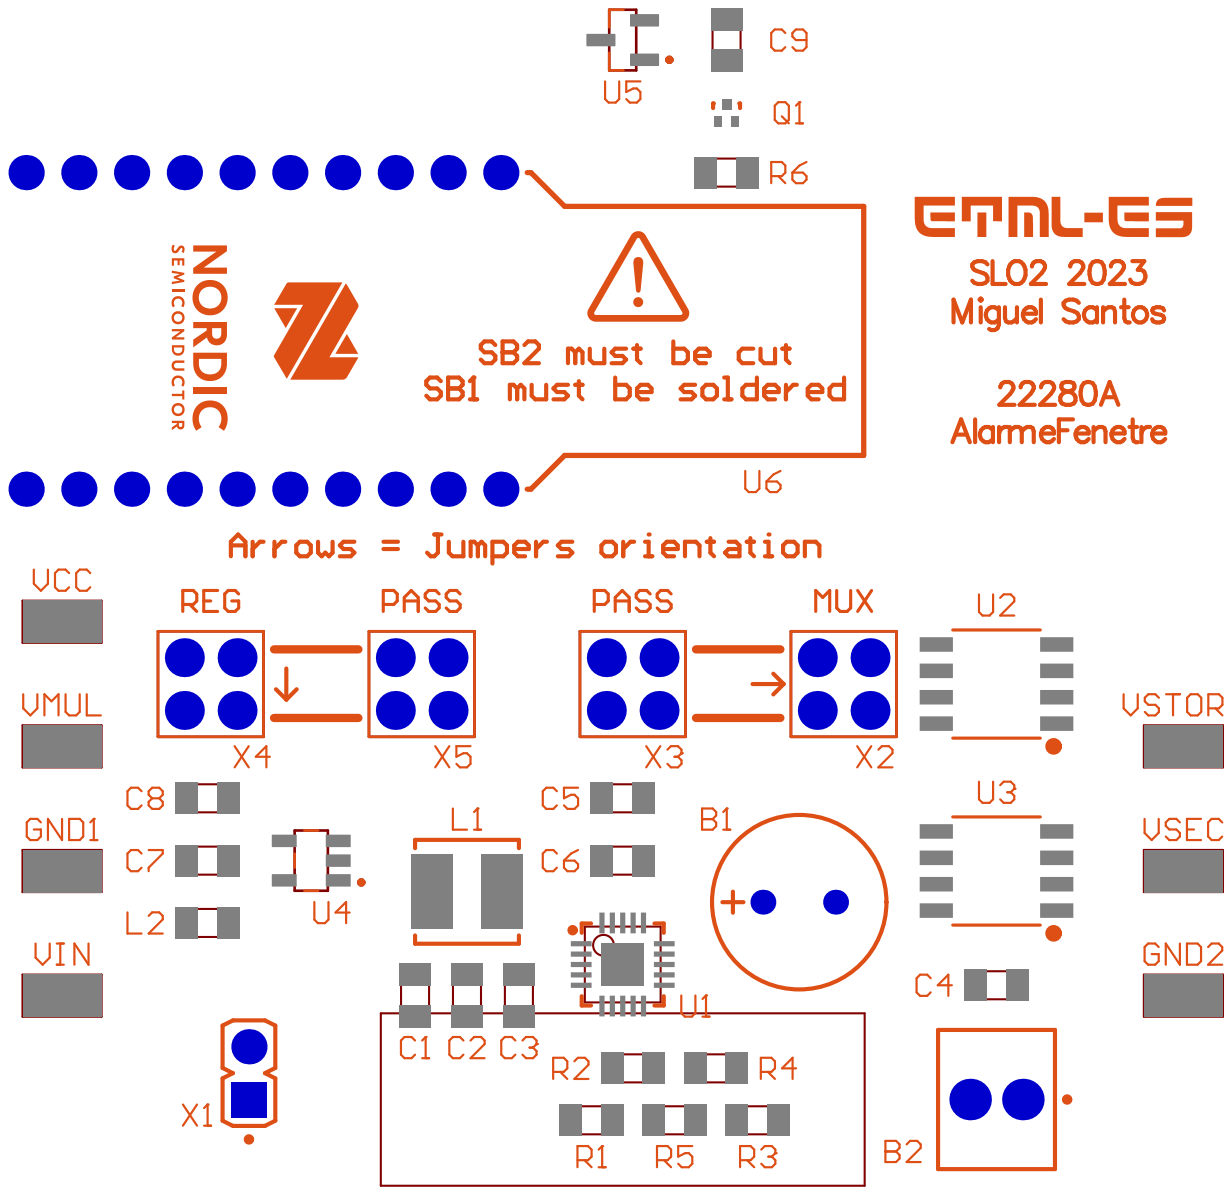
[picture p179: page 1]

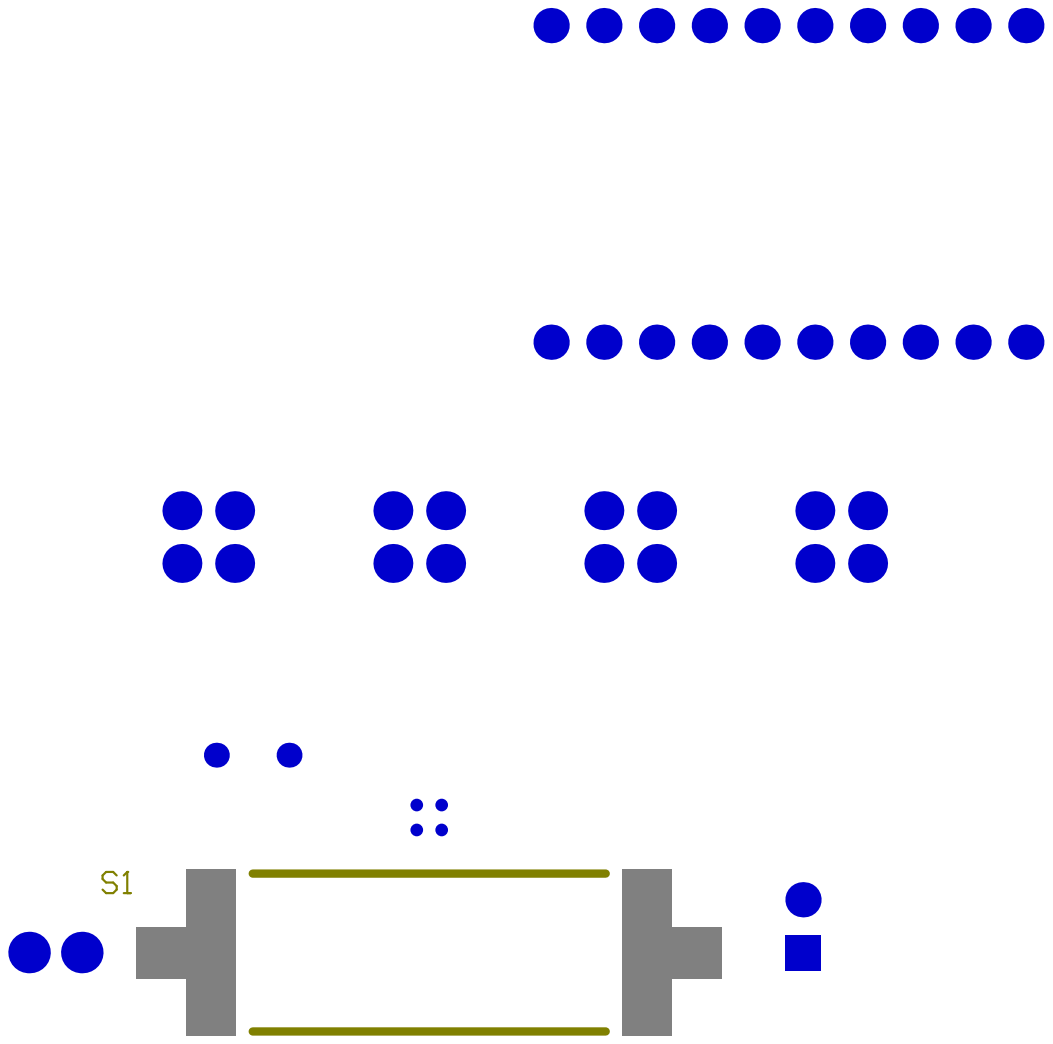
[picture p180: page 2]
