Miguel-SLO/2228_AlarmeFenetre/Rendu final/2228_AlarmeFenetreOuverte-Recepteur-PCB-V1.PDF

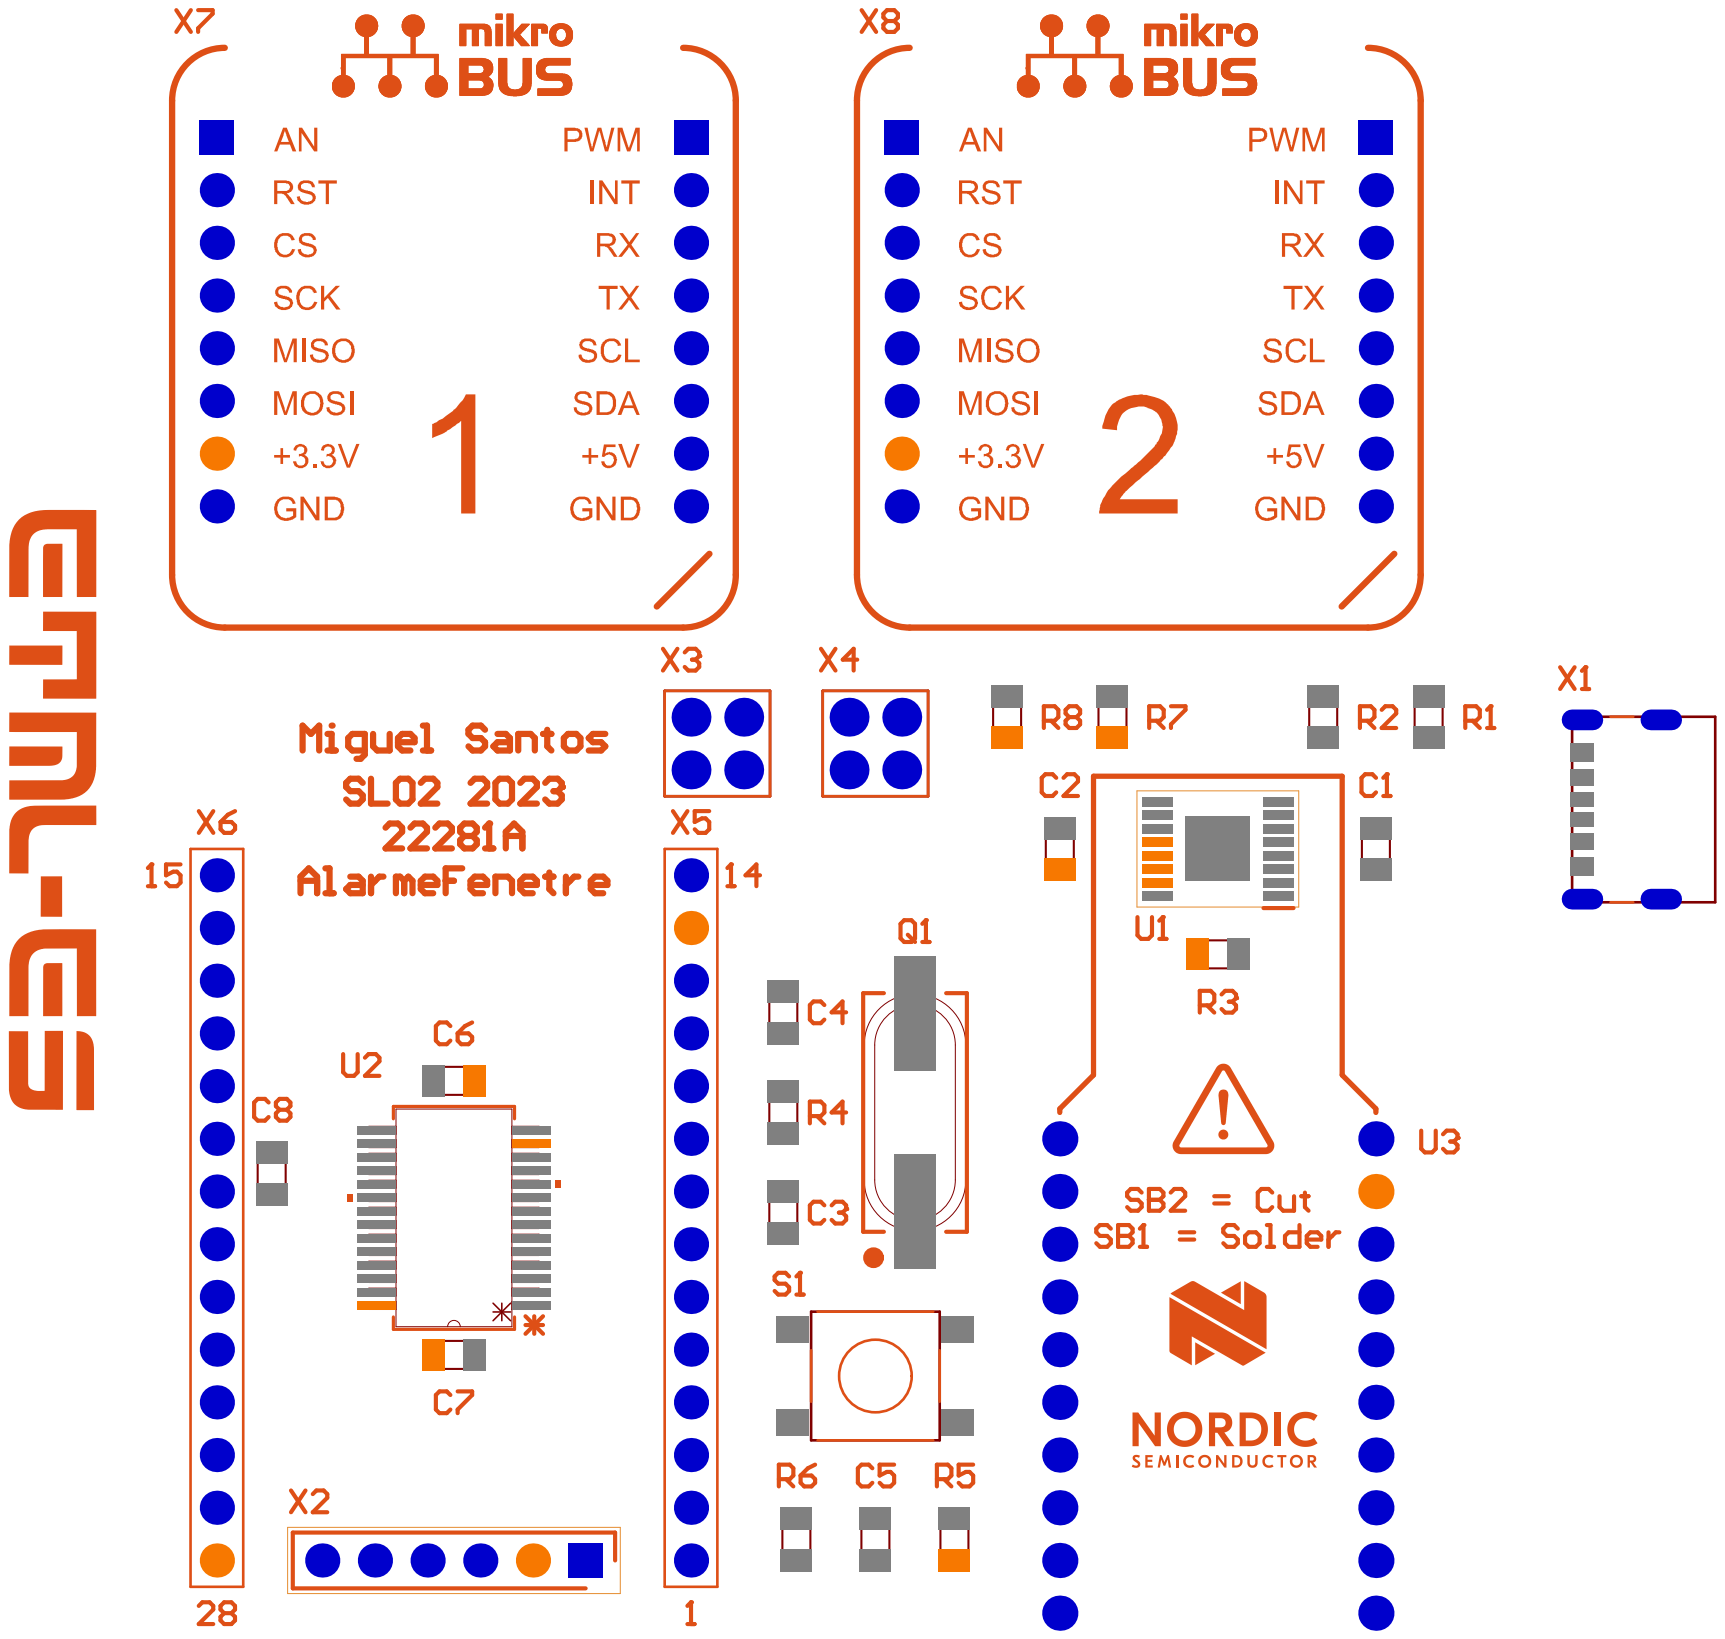
[picture p181: page 1]

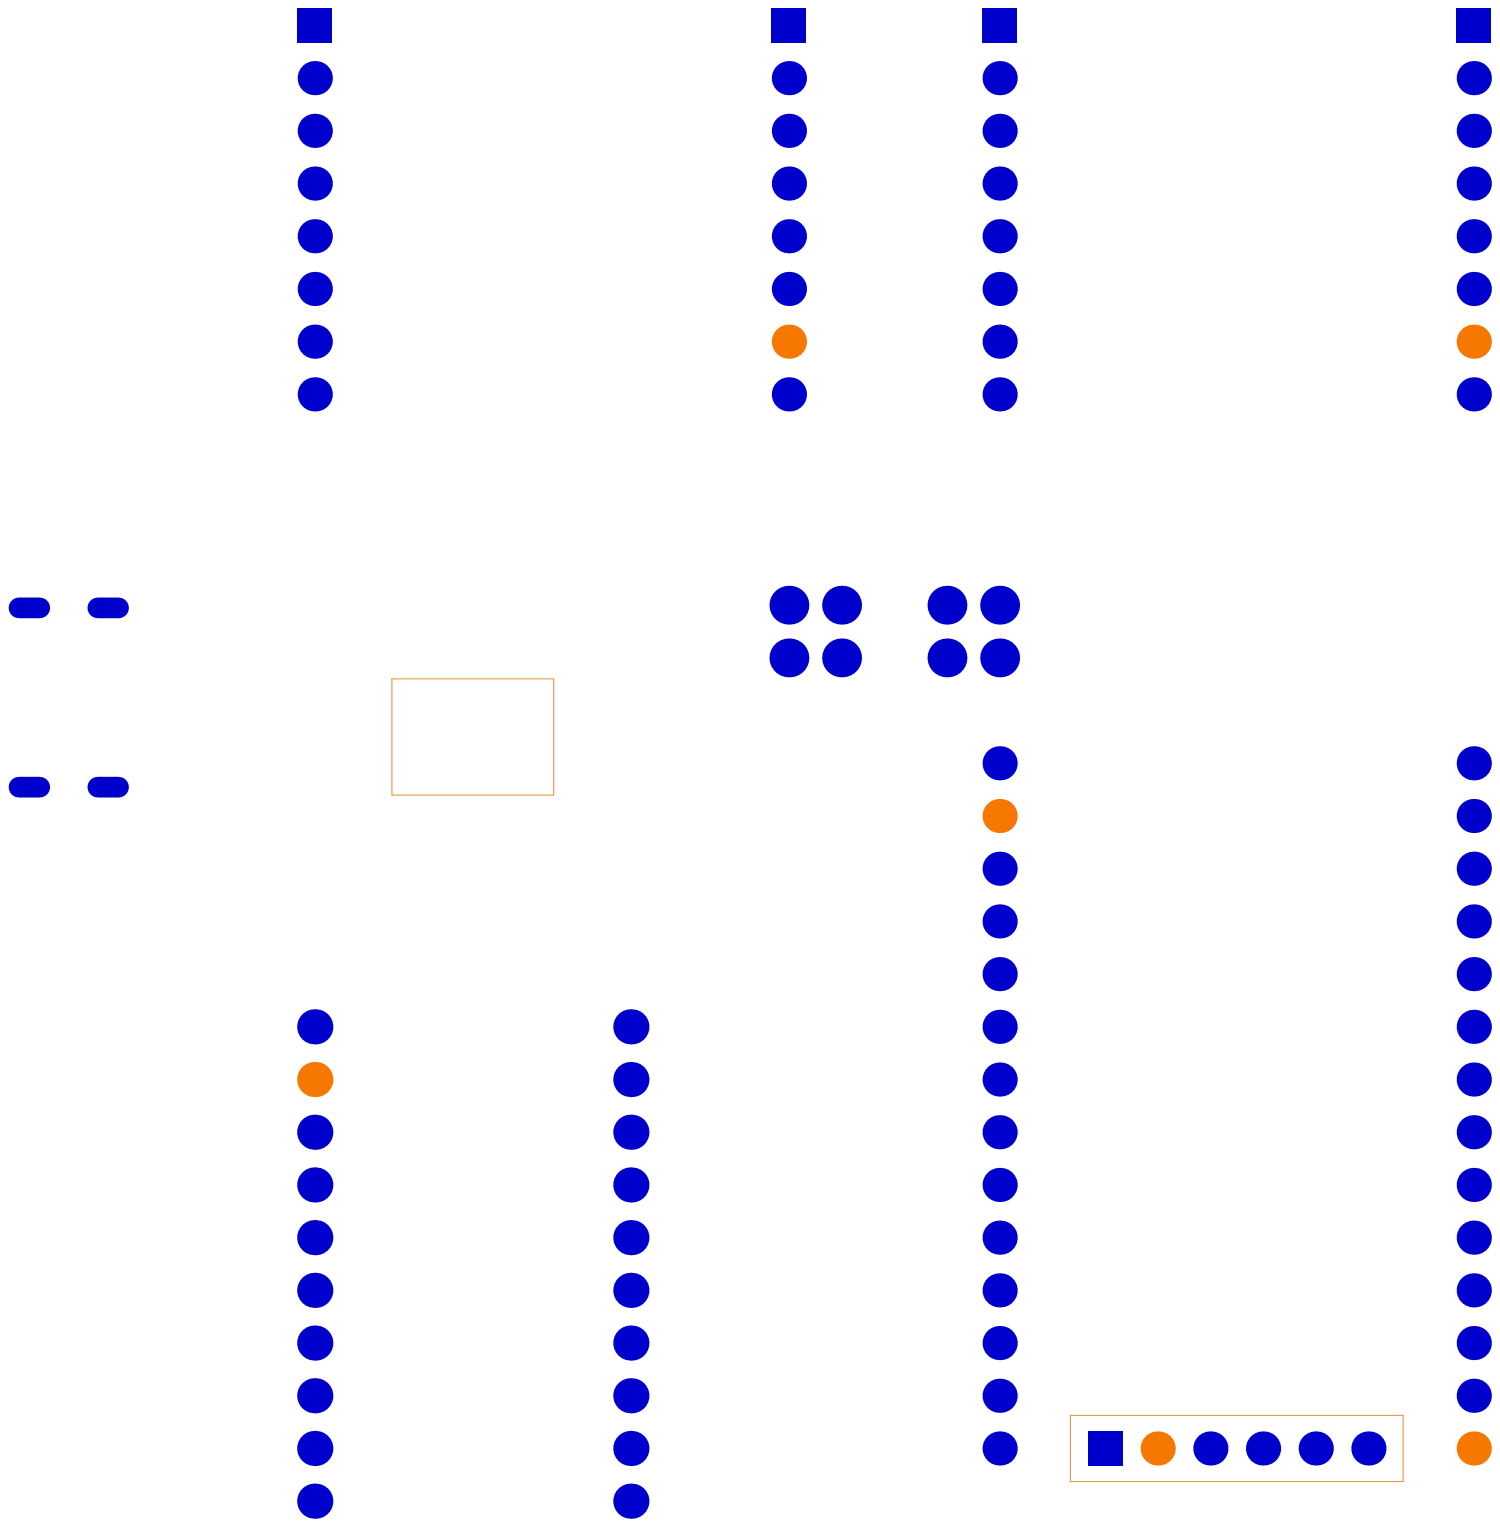
[picture p182: page 2]
