Miguel-SLO/2228_AlarmeFenetre/2228_AlarmeFenetreOuverte/doc/Rendu final/2228_AlarmeFenetreOuverte-Emetteur-Schemas-V1.PDF

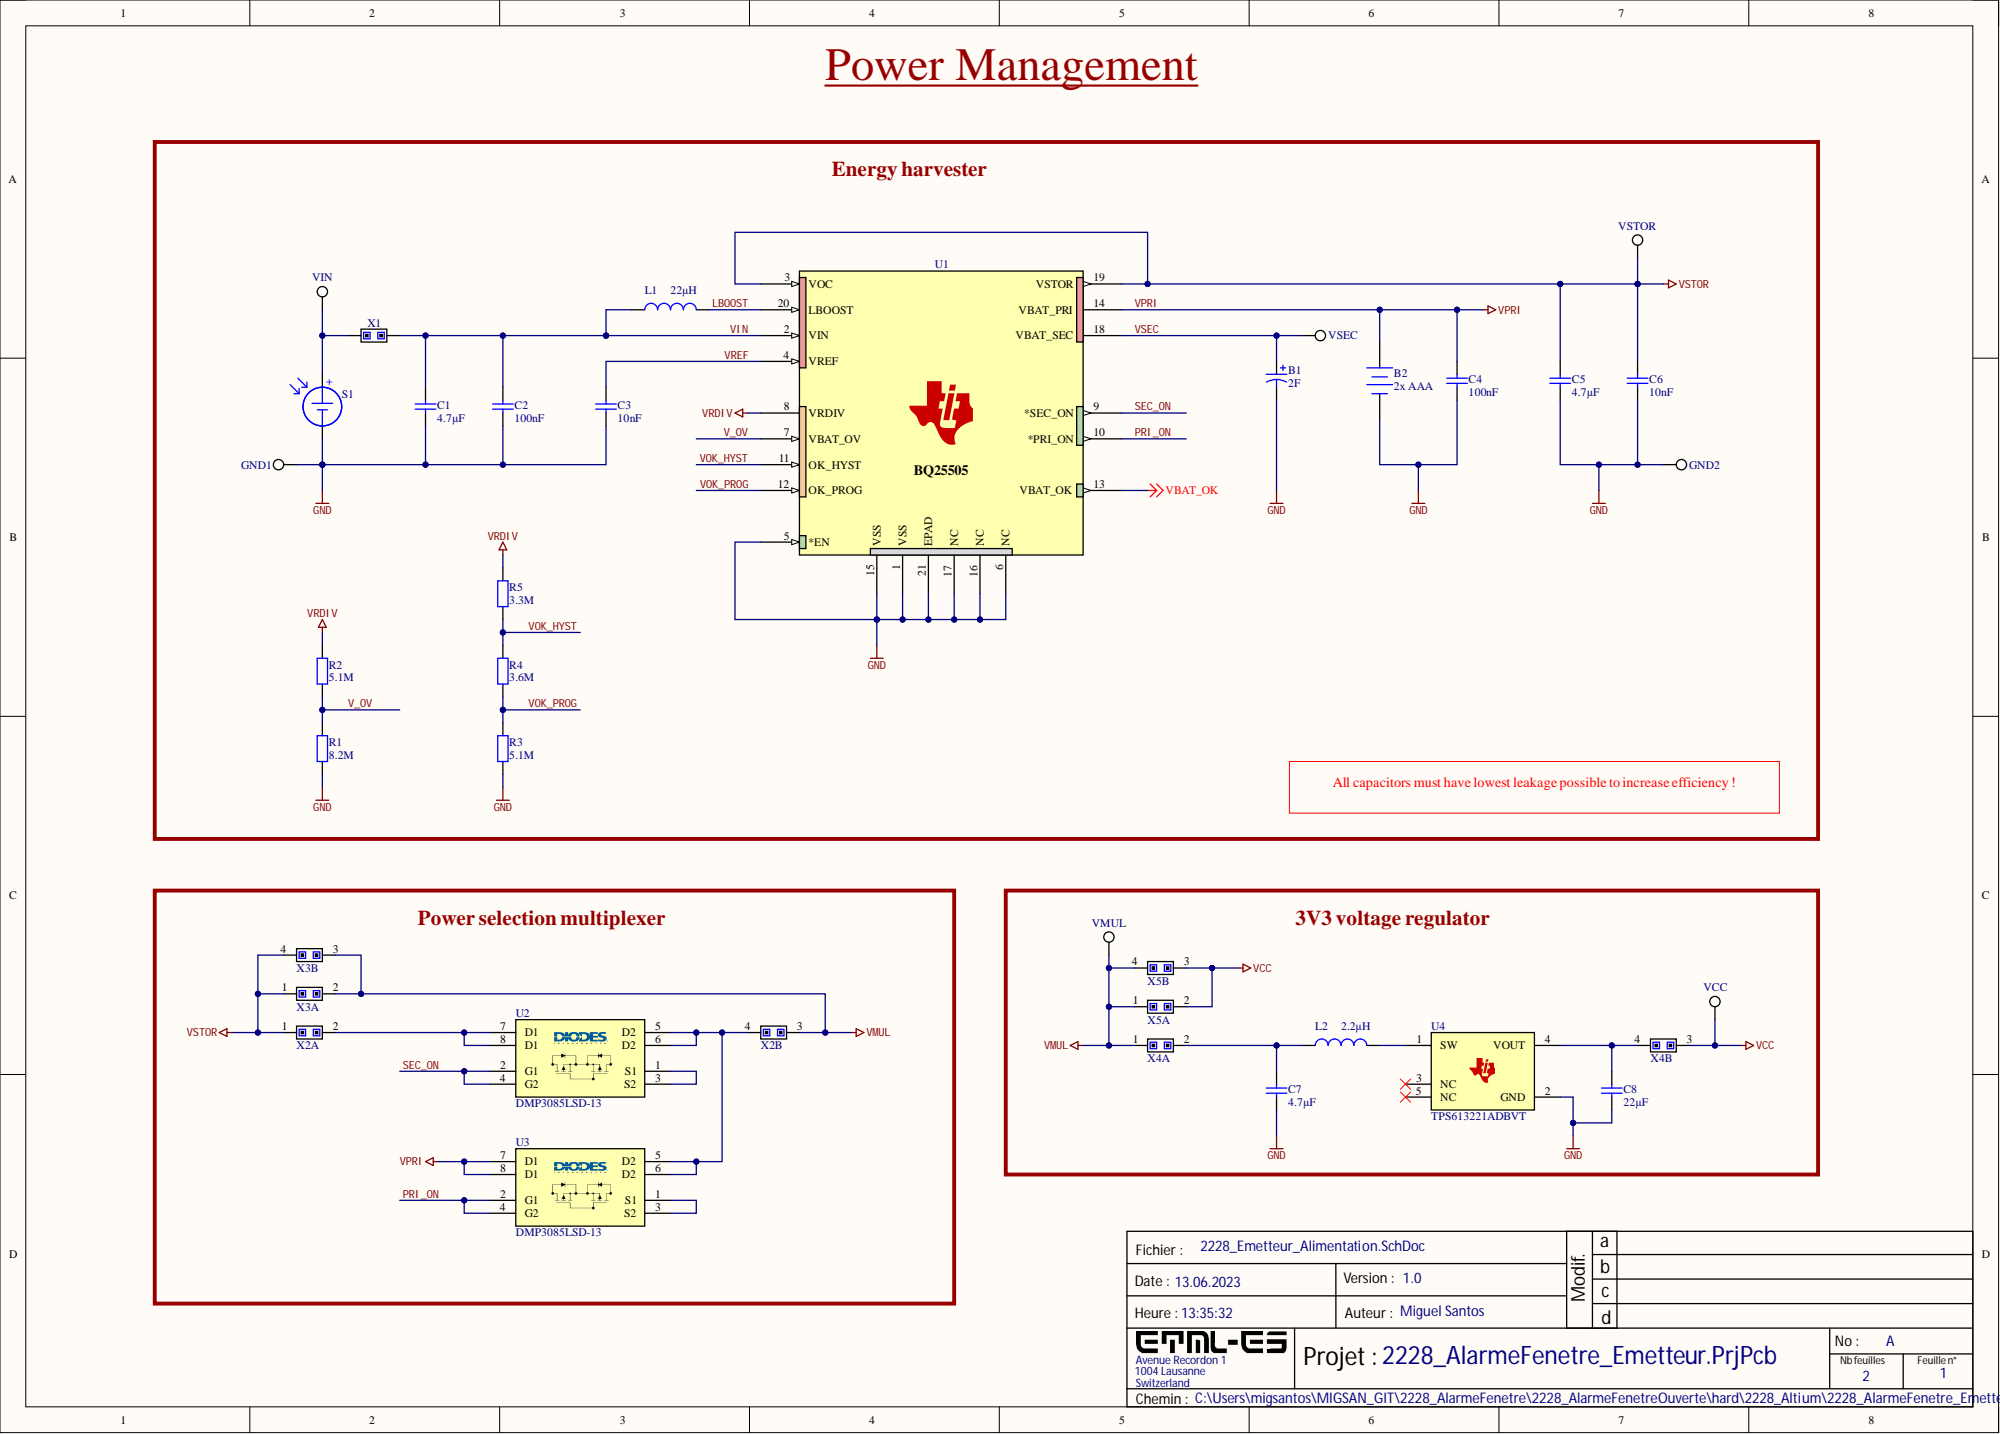
[picture p183: page 1]

All capacitors must have lowest leakage possible to increase efficiency !

2228_Emetteur_Alimentation.SchDoc Fichier : | | a

Date : 13.06.2023 | Version : 1.0

Heure : 13:35:32 | Miguel Santos Auteur :
Avenue Recordon 1 1004 Lausanne Switzerland | Projet : 2228_AlarmeFenetre_Emetteur.PrjPcb | No : A

Nb feuilles 2 | Feuille n° 1

Chemin : C:\Users\migsantos\MIGSAN_GIT\2228_AlarmeFenetre\2228_AlarmeFenetreOuverte\hard\2228_Altium\2228_AlarmeFenetre_Emetteur\2228_Emetteur_Alimentation.SchDoc

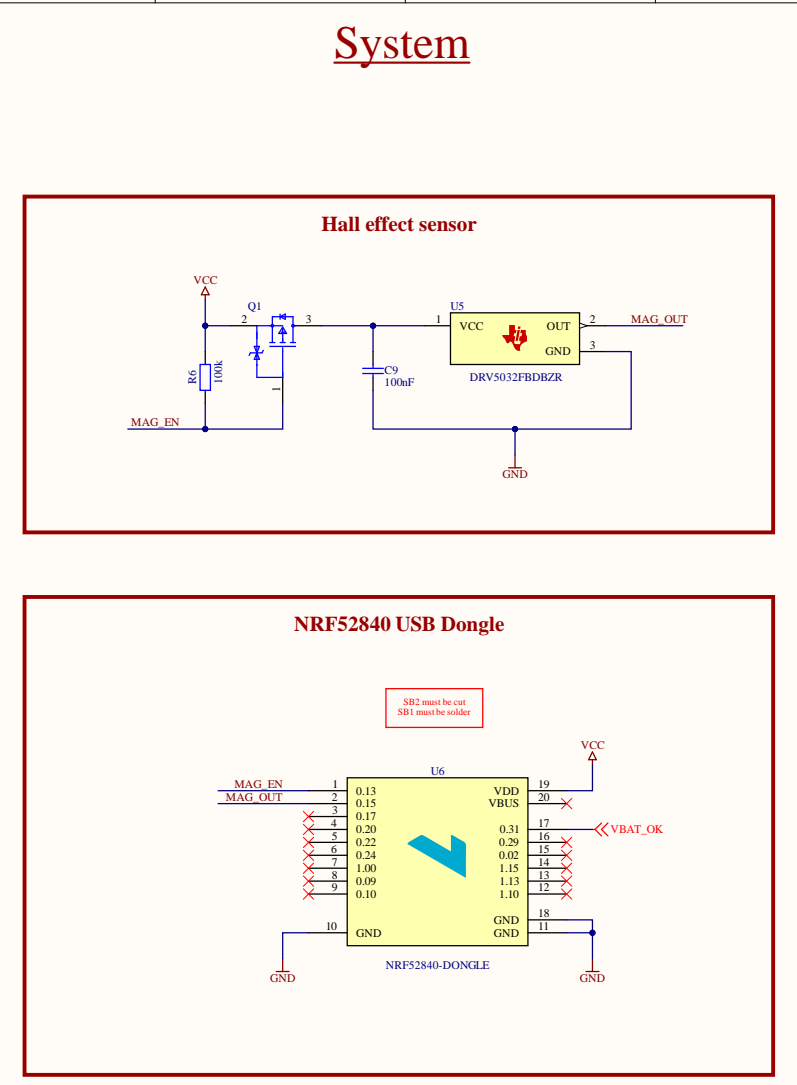
[picture p184: page 2]

2228_Emetteur_Systeme.SchDoc Fichier : | | a

Date : 13.06.2023 | Version : 1.0

Heure : 13:35:33 | Miguel Santos Auteur :
Avenue Recordon 1 1004 Lausanne Switzerland | Projet : 2228_AlarmeFenetre_Emetteur.PrjPcb | No : A

Nb feuilles 2 | Feuille n° 2

Chemin : C:\Users\migsantos\MIGSAN_GIT\2228_AlarmeFenetre\2228_AlarmeFenetreOuverte\hard\2228_Altium\2228_AlarmeFenetre_Emetteur\2228_Emetteur_Systeme.SchDoc
