Miguel-SLO/2228_AlarmeFenetre/2228_AlarmeFenetreOuverte/doc/Rendu final/2228_AlarmeFenetreOuverte-Recepteur-Schemas-V1.PDF

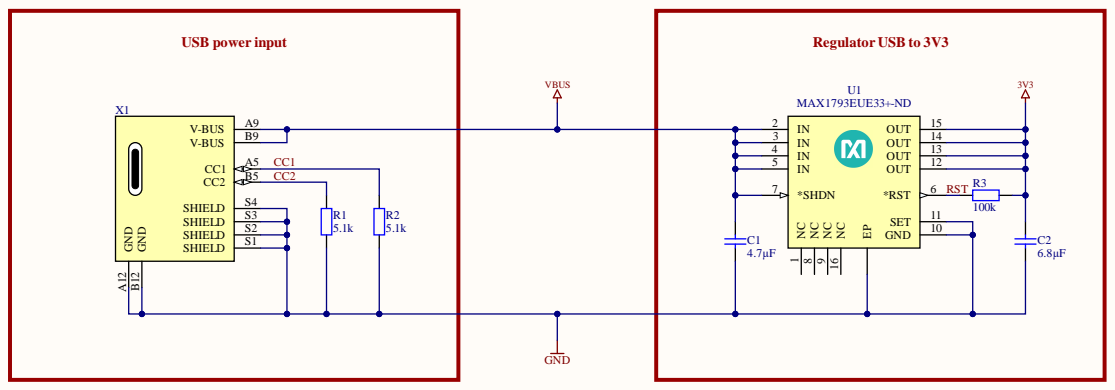
[picture p185: page 1]

2228_Recepteur_Alimentation. SchDoc Fichier :

Date : 13.06.2023 | Version : 1. 0

Heure : 13:44:05 | Miguel Santos Auteur :
Avenue Re cordon 1 004 Lausanne Switzerland | Projet : 2228_AlarmeFenetre_Recepteur.PrjPcb | No : B

Nb feui l es | F eui e n°

Chemin : C:\Users\migsantos\MI

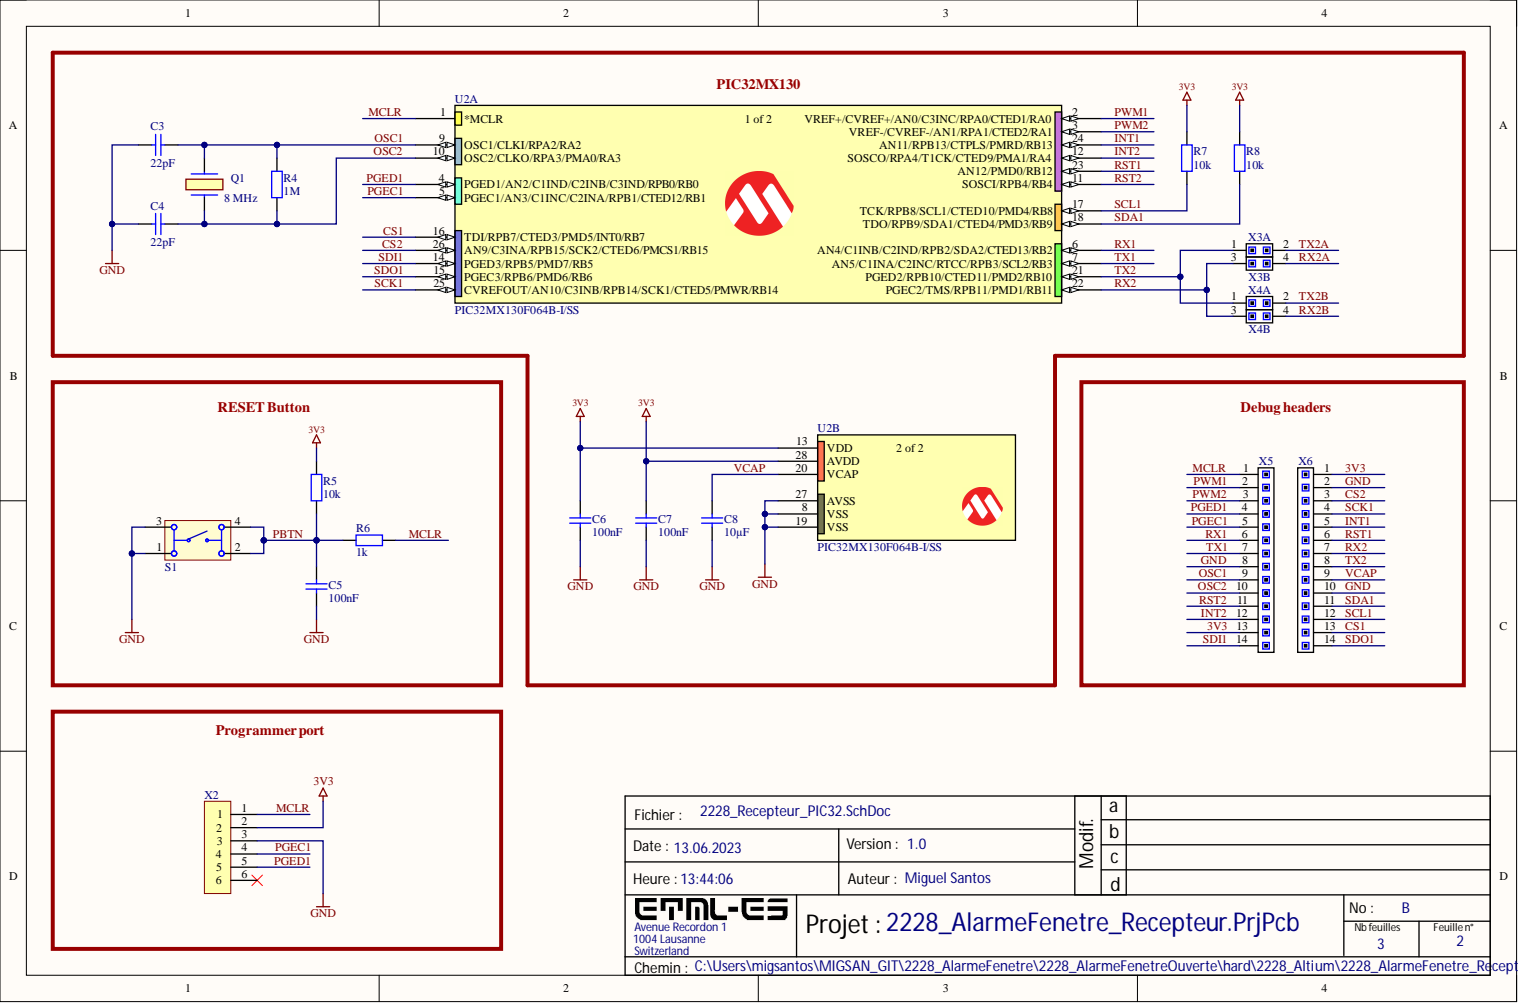
[picture p186: page 2]

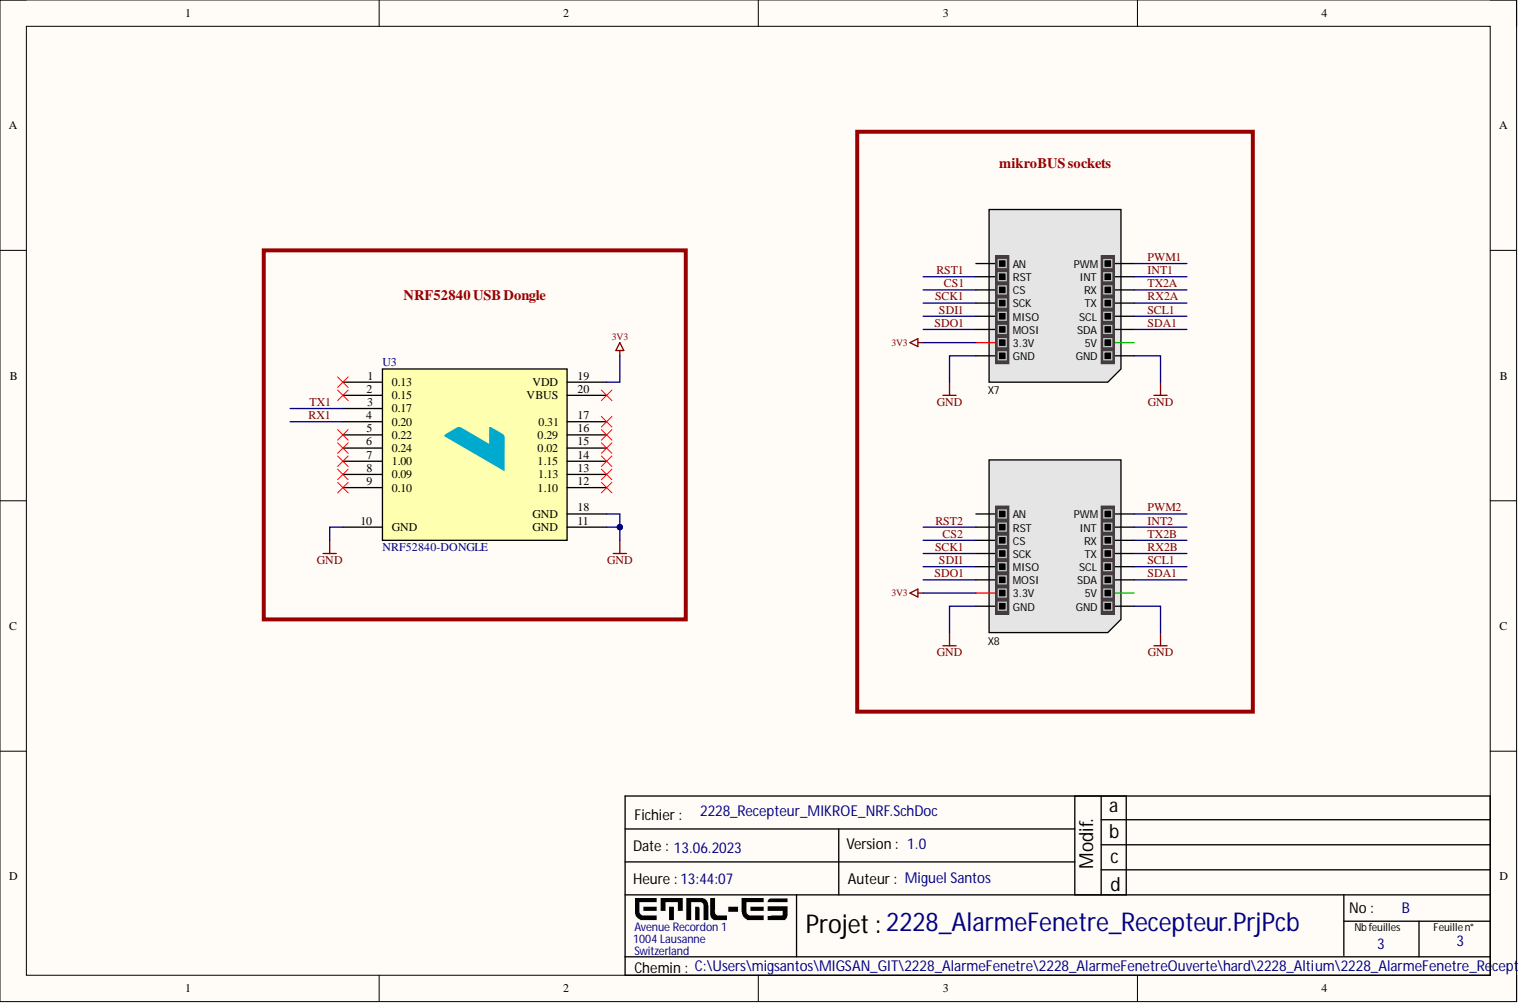
[picture p187: page 3]

2228_Recepteur_MIKR O E_NR F. SchDoc Fichier :

Date : 13.06.2023 | Version : 1. 0

Heure : 13:44:07 | Miguel Santos Auteur :

: 2228_AlarmeFenetre_Recepteur.PrjPcb | No : B
