Miguel-SLO/2228_AlarmeFenetre/(list of files, drawings)

Other design files:
2228_AlarmeFenetreOuverte/hard/2228_Altium/2228_AlarmeFenetre_Emetteur/2228_AlarmeFenetre_Emetteur.PrjPcb
2228_AlarmeFenetreOuverte/hard/2228_Altium/2228_AlarmeFenetre_Emetteur/2228_Emetteur_Alimentation.SchDoc
2228_AlarmeFenetreOuverte/hard/2228_Altium/2228_AlarmeFenetre_Emetteur/2228_Emetteur_Systeme.SchDoc
2228_AlarmeFenetreOuverte/hard/2228_Altium/2228_AlarmeFenetre_Librairies/2228_AlarmeFenetre_Symbols.SchLib
2228_AlarmeFenetreOuverte/hard/2228_Altium/2228_AlarmeFenetre_Recepteur/2228_AlarmeFenetre_Recepteur.PrjPcb
2228_AlarmeFenetreOuverte/hard/2228_Altium/2228_AlarmeFenetre_Recepteur/2228_Recepteur_Alimentation.SchDoc
2228_AlarmeFenetreOuverte/hard/2228_Altium/2228_AlarmeFenetre_Recepteur/2228_Recepteur_MIKROE_NRF.SchDoc
2228_AlarmeFenetreOuverte/hard/2228_Altium/2228_AlarmeFenetre_Recepteur/2228_Recepteur_PIC32.SchDoc
