Miguel-SLO/2228_AlarmeFenetre/(commit log)

2023-03-29 Ajout dossier "Pré-étude"
    [2228_Planning.xlsx, estimations.xlsx]
2023-03-29 Ajout dossier "PCB"
    [2228_AlarmeFenetre_Emetteur.PrjPcb, 2228_AlarmeFenetre_Recepteur.PrjPcb, 2228_AlarmeFenetre_Symbols.SchLib, 2228_Emetteur_Alimentation.SchDoc, 2228_Emetteur_Systeme.SchDoc, 2228_Recepteur_Alimentation.SchDoc, 2228_Recepteur_MIKROE_NRF.SchDoc, 2228_Recepteur_PIC32.SchDoc]
2023-03-29 Ajout dossier "Boitiers"
    [2228_Emetteur_Bottom_wPCB.SLDPRT, 2228_Emetteur_Bottom_wPCB.STL, 2228_Emetteur_Top.SLDPRT, 2228_Emetteur_Top.STL, keystone-PN2469.STEP, keystone-PN2469.step.SLDPRT]
2023-03-29 Ajout des dossier d'organisation
    [Grille EVALUATION proj v1-02 modèle.xlsx, bq25505SolarAppDesign_V1p3.xlsx, bq25505_Design_Help_V1_3.xlsx]
2023-04-01 Ajout projet PrusaSlicer
    [2228_Emetteur_Top.3mf]
2023-04-26 FIn de séance
    [2228_AlarmeFenetre_Recepteur.PrjPcb]
2023-05-14 New STL file
    [2228_Emetteur_Bottom_wPCB.SLDPRT, 2228_Emetteur_Bottom_wPCB_V2.STL, 2228_Emetteur_Top.SLDPRT]
2023-05-31 Compilation réussie PIC32 !
    [2228_Recepteur_PIC32.SchDoc]
2023-06-11 Création des fichiers émetteur
    [22280A_AlarmeFenetre_Emetteur_Board_Outline_(ES).gbr, 22280A_AlarmeFenetre_Emetteur_Copper_Signal_Bot.gbr, 22280A_AlarmeFenetre_Emetteur_Copper_Signal_Top.gbr, 22280A_AlarmeFenetre_Emetteur_Legend_Bot.gbr, 22280A_AlarmeFenetre_Emetteur_Legend_Top.gbr, 22280A_AlarmeFenetre_Emetteur_Pads_Bot.gbr, 22280A_AlarmeFenetre_Emetteur_Pads_Top.gbr, 22280A_AlarmeFenetre_Emetteur_Profile.gbr]
2023-06-11 Création fichiers récepteur
    [2228_AlarmeFenetre_Recepteur.PrjPcb]
2023-06-13 Création fichiers de production
    Création des différentes schématiques et fichiers de productions, gerbers, etc...
    + organisation dans le dossier correspondant
    [22280A_AlarmeFenetre_Emetteur_Board_Outline_(ES).gbr, 22280A_AlarmeFenetre_Emetteur_Copper_Signal_Bot.gbr, 22280A_AlarmeFenetre_Emetteur_Copper_Signal_Top.gbr, 22280A_AlarmeFenetre_Emetteur_Legend_Bot.gbr, 22280A_AlarmeFenetre_Emetteur_Legend_Top.gbr, 22280A_AlarmeFenetre_Emetteur_Pads_Bot.gbr, 22280A_AlarmeFenetre_Emetteur_Pads_Top.gbr, 22280A_AlarmeFenetre_Emetteur_Profile.gbr]
2023-06-13 Réorganisation doc
    [2228_Planning.xlsx, estimations.xlsx]
2023-06-13 Fichiers mécaniques
    [2228_Emetteur-Bottom-V1.STL, 2228_Emetteur_Bottom.SLDDRW, 2228_Emetteur_Bottom.SLDPRT, 2228_Emetteur_Bottom_wPCB.SLDPRT, 2228_Emetteur_Bottom_wPCB.STL, 2228_Emetteur_Bottom_wPCB_V2.STL, 2228_Emetteur_Top.3mf, 2228_Emetteur_Top.SLDDRW]
2023-06-13 MAJ des bom et autres docs
    [2228_AlarmeFenetre_Emetteur.PrjPcb, 2228_AlarmeFenetre_Emetteur.xlsx, 2228_AlarmeFenetre_Recepteur.PrjPcb, 2228_AlarmeFenetre_Recepteur.xlsx, 2228_Planning.xlsx, Estimations.xlsx, bq25505SolarAppDesign_V1p3.xlsx, bq25505_Design_Help_V1_3.xlsx]
2023-06-13 Fiche de modifications
    [2228_Emetteur_Bottom.SLDDRW, 2228_Emetteur_Top.SLDDRW]
2023-06-14 Réorganisation et rapport
    [2228_JournalDeTravail.xlsx, 2228_Planning.xlsx, Grille EVALUATION proj v1-1 modèle.xlsx, estimations.xlsx]
2023-06-16 Rendu final
    [2228_AlarmeFenetre_Emetteur.PrjPcb, 2228_AlarmeFenetre_Recepteur.PrjPcb, 2228_JournalDeTravail.xlsx, 2228_Planning.xlsx]
2023-06-18 Rapport final
    [2228_AlarmeFenetre_Emetteur.PrjPcb]
